beam-ttm/simulaciones/sonnet/adsb_patch/reports/limitations.md

# Limitaciones y estado de validación

- **Simulación sin completar:** el primer ensayo local falló por licencia y otros intentos locales fueron terminados por falta de memoria. El servidor remoto Windows ya es accesible. El intento del 19/10/2026 a las 16:24:24 comenzó a 0,8 GHz y falló en el mallado conformal. Se cambió el mallado planar a RECTANGULAR, conservando la geometría; falta repetirlo. No hay resultados S11 ni de radiación completados y no se realizó convergencia.
- **Geometría de alimentación existente:** el relleno F.Cu es una zona sin net asignada y deja un despeje de 0,2545 mm respecto del pad RF. La separación fue confirmada geométricamente y contra Gerber. No se reparó ni se asumió una unión ideal. La intención de diseño de esa separación no está determinada.
- **Material real sin certificar:** KiCad declara tanδ=0. Esto es una base sin pérdidas dieléctricas, no un valor físico validado. Los nombres JLC2116/JLC Core no bastan para seleccionar inequívocamente una ficha de laminado. El caso tanδ=0,016 es sensibilidad ilustrativa. σCu=5,8×10⁷ S/m es una hipótesis de cobre macizo liso usada también en ejemplos de Sonnet, no una medición de la lámina fabricada. No se incluyen rugosidad ni acabado ENIG.
- **Pared metalizada desconocida:** se supone 25 µm, interpretable como pared alrededor de un diámetro interior igual al taladro nominal. El archivo de fabricación no aclara aquí diámetro terminado frente a diámetro de herramienta. Se incluyen casos de 10 y 35 µm para la vía RF. La sección circular se aproxima por polígonos con error de cuerda máximo de 1 µm; la malla del solver introduce otra aproximación.
- **Dieléctrico finito:** Sonnet GEO utiliza capas uniformes extendidas hasta la caja. El contorno real se conserva en el JSON y en el recorte del cobre, pero no se representa el borde lateral FR4/aire de la placa con un sólido dieléctrico finito. Los interiores de perforaciones tampoco se sustituyen por cilindros de aire dentro de las capas uniformes. Esto puede afectar el campo y la radiación; contrastar con un solver 3D si es necesario.
- **Máscaras omitidas:** el Gerber Job declara 10 µm por cara y 1,598 mm total. Cobre más dieléctricos suma 1,578 mm; no se oculta la diferencia. Las propiedades RF de las máscaras no están disponibles.
- **Modelo de lámina:** se usa THIN_METAL con espesores físicos para pérdidas y planos situados en centros de lámina. La propagación entre centros utiliza el dieléctrico adyacente en la corrección de medio espesor de cobre. No es un volumen 3D exacto de las cuatro láminas.
- **Excitación local:** terminal flotante +1 en pad de D1 y −1 en cobre de masa adyacente; referencia de 50 Ω. Se conservan pads/pistas del resto de la electrónica, pero no componentes, soldadura, cables, conectores, receptor, cargas, selección física del jumper ni estructura del CubeSat. Las redes abiertas pueden acoplarse electromagnéticamente; no es el S11 de todo el equipo montado.
- **Discretización y caja pendientes:** se preparan celdas 100/50/25 µm, cajas 1600/2000/2400 mm y alturas de aire 30/40/50 mm. Las paredes laterales son PEC; las tapas Free Space aproximan absorción. Aumentar caja y refinar malla simultáneamente puede requerir mucha memoria. No se ha demostrado independencia de caja ni de malla.
- **Modelo B:** se entrega un control que elimina sólo el barril RF, manteniendo el mismo cobre y excitación. No se representa como una conexión ideal. Un modelo ideal completo requiere definir cómo se pretende excitar el patch separado; no se inventó un circuito equivalente.
- **Verificación parcial:** la comparación independiente de cobre, contorno y perforaciones acredita la conversión geométrica dentro de la tolerancia indicada. `verify_project` y `get num_ports` acreditan que Sonnet interpreta el archivo y reconoce un puerto. Ninguna de estas comprobaciones valida resonancia, adaptación, radiación o polarización.

Los archivos `reports/*_prepare.log`, `reports/*_prepare.json`, `reports/*_xml_verification.json`, `reports/geometry_verification.json` y `reports/solver_status.json` distinguen estas comprobaciones de una simulación completada.
