beam-ttm/simulaciones/diseno_final_patch_1090/imagenes_stand/04_render_3d_top_patch_gold.png

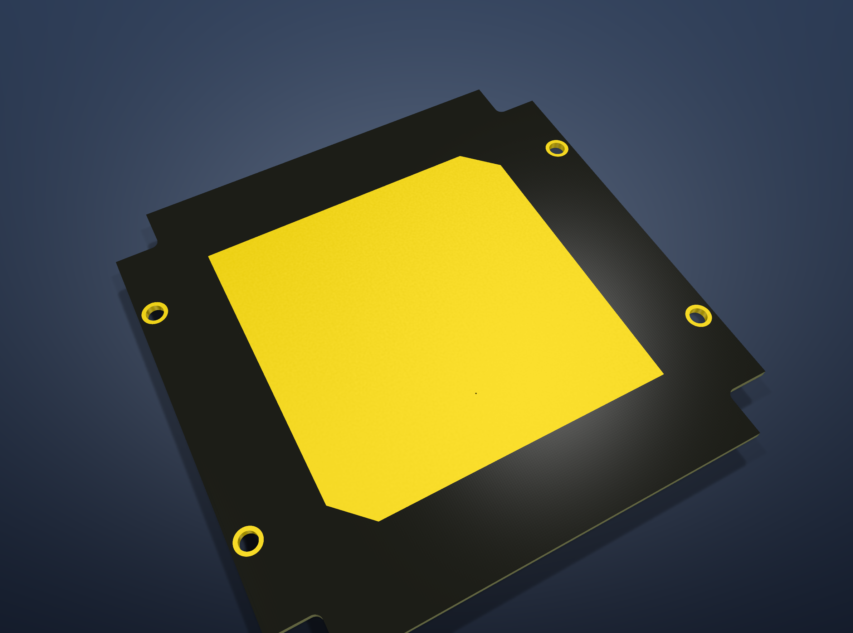
diseno_final_patch_1090/imagenes_stand/04_render_3d_top_patch_gold.png
