beam-ttm/simulaciones/diseno_final_patch_1090/imagenes_stand/05_render_3d_bottom_rf_unlam_beam.png

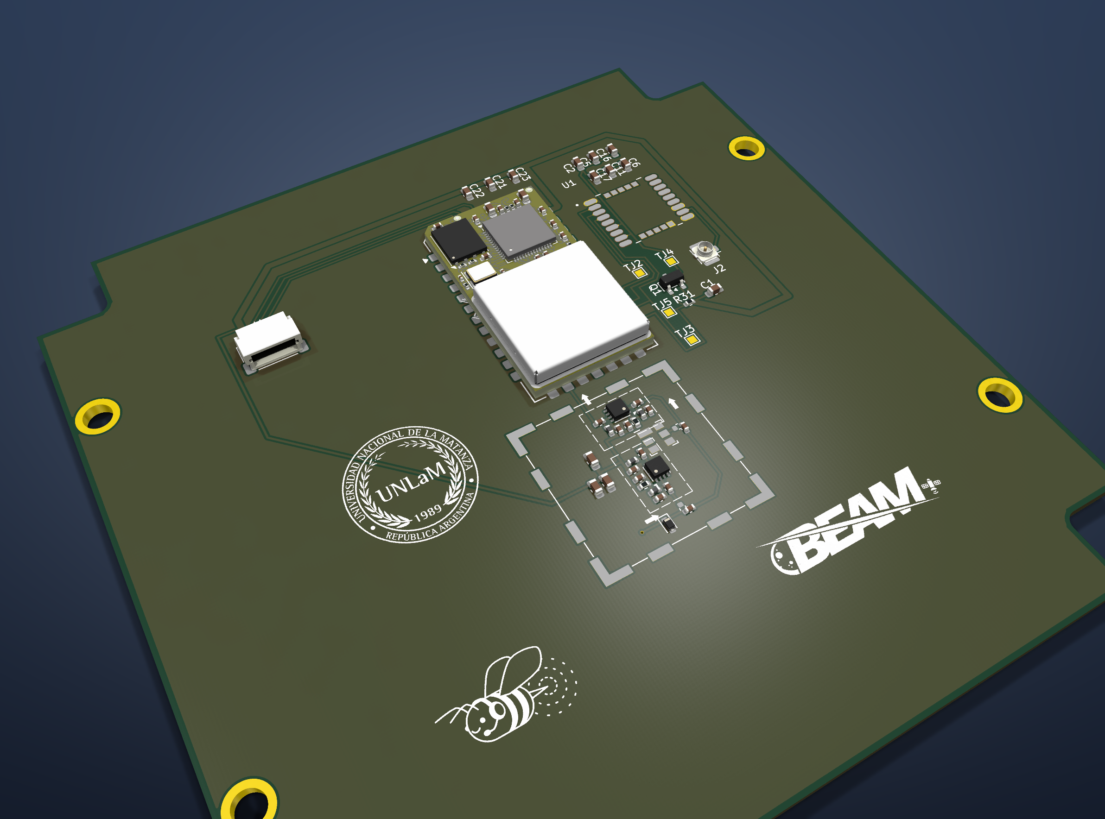
diseno_final_patch_1090/imagenes_stand/05_render_3d_bottom_rf_unlam_beam.png
