beam-ttm/simulaciones/diseno_final_patch_1090/imagenes_stand/detalle_level3_bcu_gcpw_sonnet.png

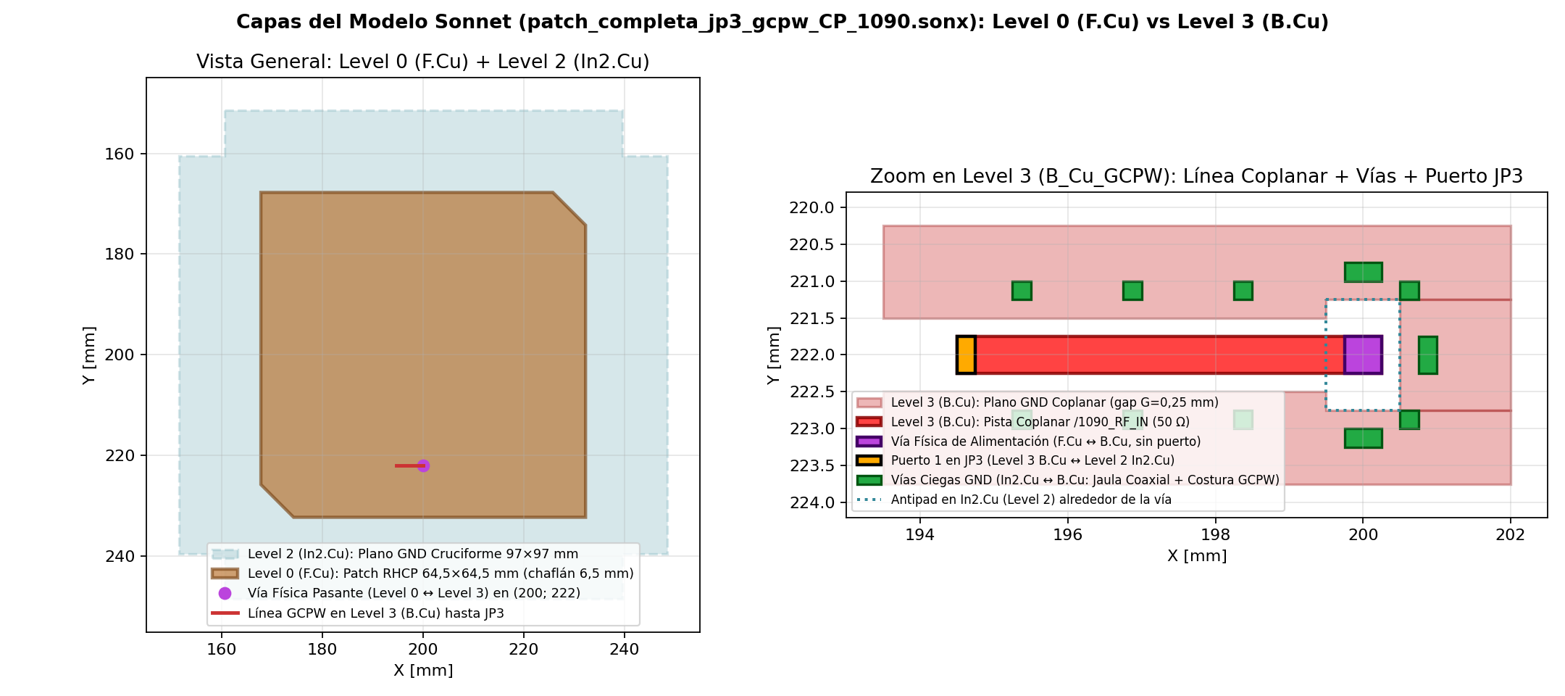
diseno_final_patch_1090/imagenes_stand/detalle_level3_bcu_gcpw_sonnet.png
