beam-ttm/simulaciones/sonnet/adsb_patch/reports/altium_sonnet_comparison.png

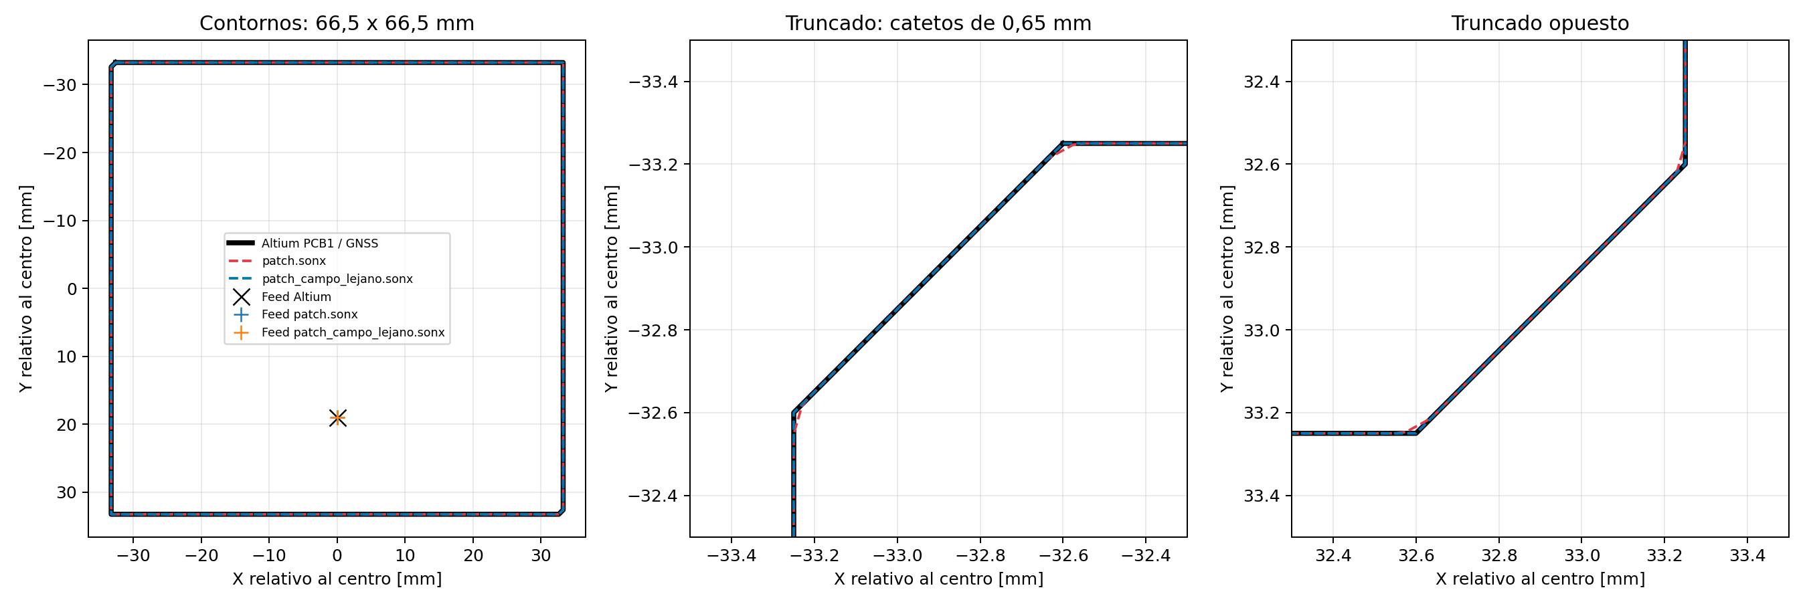
sonnet/adsb_patch/reports/altium_sonnet_comparison.png
