beam-ttm/simulaciones/sonnet/adsb_patch/reports/copper_layers.png

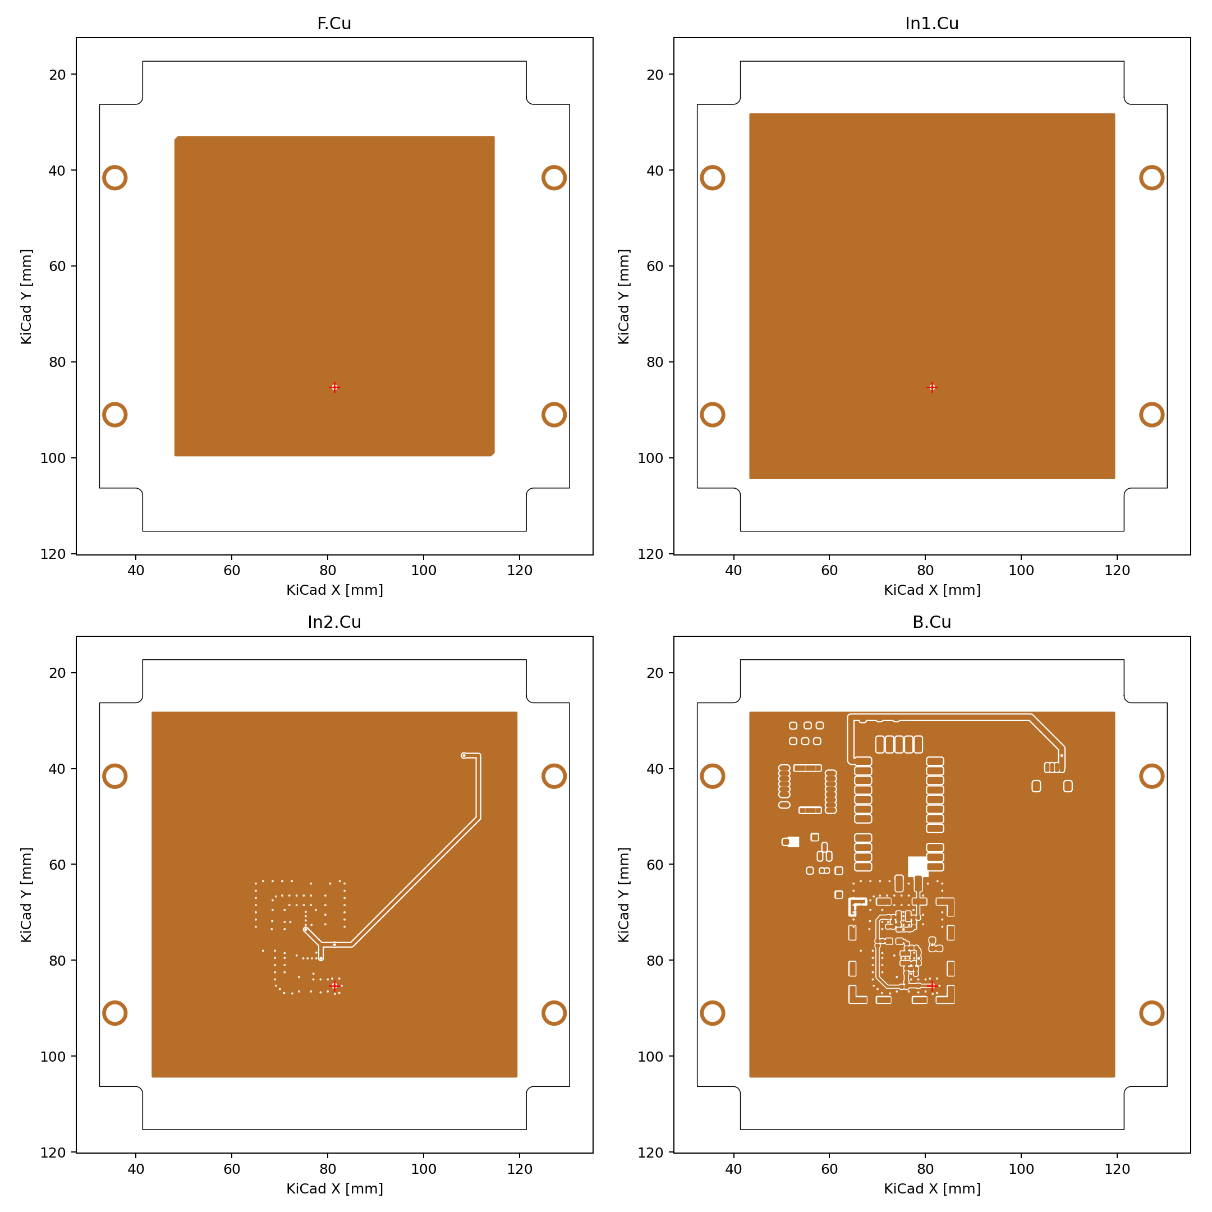
sonnet/adsb_patch/reports/copper_layers.png
