beam-ttm/simulaciones/sonnet/adsb_patch/reports/feed_via_detail.png

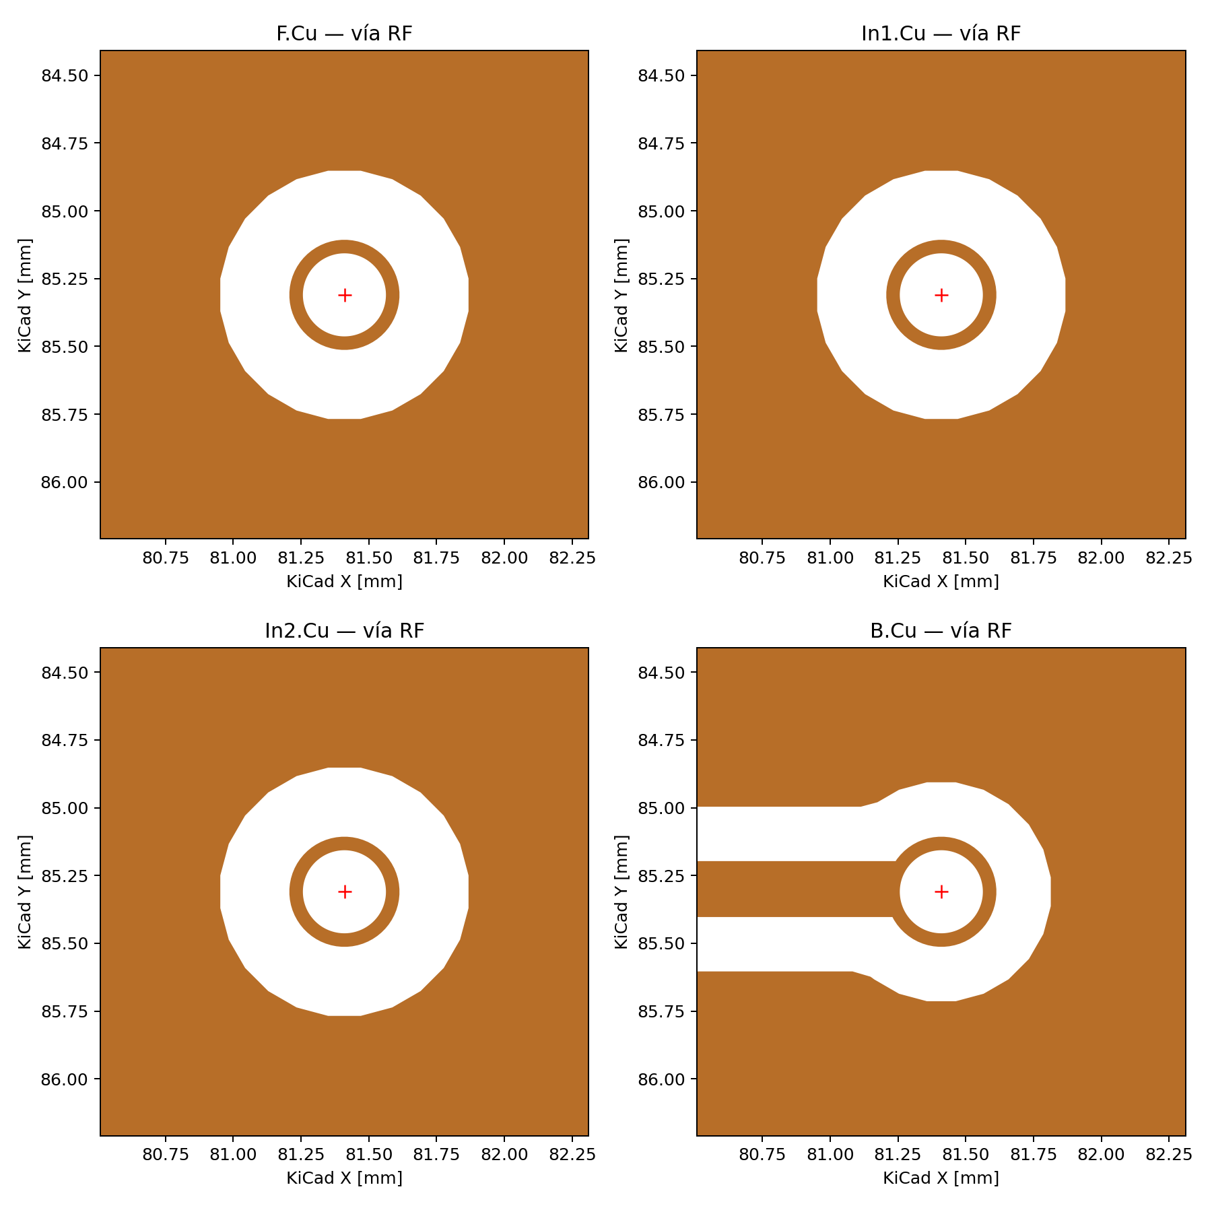
sonnet/adsb_patch/reports/feed_via_detail.png
