beam-ttm/simulaciones/sonnet/adsb_patch/results/patch_2caras_h16/patch_2caras_h16_barrido_rapido.csv

frequency_Hz | S11_real | S11_imag | S11_dB | return_loss_dB | VSWR | Zin_real_ohm | Zin_imag_ohm
800000000.0 | -0.952092726177147 | 0.285822625073251 | -0.05166079474580209 | 0.05166079474580209 | 336.26719394841723 | 0.15189841100020715 | 7.343169237821474
802000000.0 | -0.951500651691796 | 0.287531329952107 | -0.05230854953286738 | 0.05230854953286738 | 332.1031061597402 | 0.15384418805066188 | 7.389596057320951
804000000.0 | -0.950899383718565 | 0.289251860244356 | -0.052974438229811065 | 0.052974438229811065 | 327.92859545646576 | 0.1558449388642854 | 7.43640167800003
806000000.0 | -0.950288692364075 | 0.290984483398063 | -0.053659023360235196 | 0.053659023360235196 | 323.74488830898673 | 0.1579024001570856 | 7.4835953135473465
808000000.0 | -0.949668339486988 | 0.292729474259709 | -0.05436289053086747 | 0.05436289053086747 | 319.5532064948163 | 0.1600183810180816 | 7.531186464974012
810000000.0 | -0.94903807833877 | 0.294487115325254 | -0.05508664954260451 | 0.05508664954260451 | 315.35476649425874 | 0.1621947664573099 | 7.579184931957993
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
