beam-ttm/simulaciones/sonnet/adsb_patch/results/patch_2caras_h16/patch_2caras_h16_rect_b1228.8_c100um_local.csv

frequency_Hz | S11_real | S11_imag | S11_dB | return_loss_dB | VSWR | Zin_real_ohm | Zin_imag_ohm
1090000000.0 | -0.568895073187 | -0.360107620829 | -3.435959793780178 | 3.435959793780178 | 5.1216324559836846 | 10.549167258824852 | -13.897816965197206
