beam-ttm/simulaciones/sonnet/adsb_patch/results/patch_2caras_h16/patch_2caras_h16_rect_b1638.4_c100um.csv

frequency_Hz | S11_real | S11_imag | S11_dB | return_loss_dB | VSWR | Zin_real_ohm | Zin_imag_ohm
1090000000.0 | -0.568895144267 | -0.360107622907 | -3.4359590046417403 | 3.4359590046417403 | 5.121633602144371 | 10.549164755206556 | -13.897815841089136
