beam-ttm/simulaciones/sonnet/adsb_patch/results/patch_2caras_h16/patch_2caras_h16_rect_b1638.4_c100um_campo.csv

/home/alan/Escritorio/CubeSat/sonnet/patch_2caras_h16_rect_b1638.4_c100um.sonx
Theta (Degrees) | patch_2caras_h16_rect_b1638.4_c100um: E-Total F=1.09 GHz Phi=0°
-90 | -112.121905735198
-85 | -11.3234848083483
-80 | -9.35300397293157
-75 | -8.35842430719048
-70 | -7.55311200414934
-65 | -6.82494420938843
-60 | -6.15015987942218
-55 | -5.52362705266198
-50 | -4.94507494036574
-45 | -4.41560759719049
-40 | -3.93670071696576
-35 | -3.50988862893889
-30 | -3.13665357085377
-25 | -2.81837323176936
-20 | -2.55628408725714
-15 | -2.35144955375734
-10 | -2.20473156005572
-5 | -2.11676661895773
0 | -2.08794774494923
5 | -2.1184132215203
10 | -2.20804278328059
15 | -2.35646136493169
20 | -2.5630501725643
25 | -2.82696441202545
30 | -3.14715655323808
35 | -3.52240363571208
40 | -3.95133732951932
45 | -4.43247786259532
50 | -4.96428235559109
55 | -5.54524939668507
60 | -6.17422292138856
65 | -6.85138200670733
70 | -7.58170769370074
75 | -8.38872164626692
80 | -9.38415822947032
85 | -11.3536927294109
90 | -112.153570489642
/home/alan/Escritorio/CubeSat/sonnet/patch_2caras_h16_rect_b1638.4_c100um.sonx
Theta (Degrees) | patch_2caras_h16_rect_b1638.4_c100um: E-Total F=1.09 GHz Phi=90°
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
