beam-ttm/simulaciones/sonnet/adsb_patch/results/patch_2caras_h16/patch_2caras_h16_rect_b1638.4_c100um_esfera.csv

/home/alan/Escritorio/CubeSat/sonnet/patch_2caras_h16_rect_b1638.4_c100um.sonx
Theta (Degrees) | patch_2caras_h16_rect_b1638.4_c100um: E-Total F=1.09 GHz Phi=0°
0 | -2.08794774494923
5 | -2.1184132215203
10 | -2.20804278328059
15 | -2.35646136493169
20 | -2.5630501725643
25 | -2.82696441202545
30 | -3.14715655323808
35 | -3.52240363571208
40 | -3.95133732951932
45 | -4.43247786259532
50 | -4.96428235559109
55 | -5.54524939668507
60 | -6.17422292138856
65 | -6.85138200670733
70 | -7.58170769370074
75 | -8.38872164626692
80 | -9.38415822947032
85 | -11.3536927294109
90 | -112.153570489642
95 | -13.9418052796713
100 | -13.2319880651126
105 | -13.3039887532304
110 | -13.2998663606515
115 | -13.0872919614549
120 | -12.6758919208192
125 | -12.1249591229616
130 | -11.5017815809644
135 | -10.8617560000337
140 | -10.2437454833577
145 | -9.67263376846781
150 | -9.1635205341337
155 | -8.72527886400405
160 | -8.36302010298955
165 | -8.07964796989636
170 | -7.87678847565395
175 | -7.75532595321573
180 | -7.71569811191792
/home/alan/Escritorio/CubeSat/sonnet/patch_2caras_h16_rect_b1638.4_c100um.sonx
Theta (Degrees) | patch_2caras_h16_rect_b1638.4_c100um: E-Total F=1.09 GHz Phi=5°
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
