beam-ttm/simulaciones/sonnet/adsb_patch/results/patch_2caras_h16/patch_2caras_h16_rect_b400_c100um.csv

frequency_Hz | S11_real | S11_imag | S11_dB | return_loss_dB | VSWR | Zin_real_ohm | Zin_imag_ohm
1090000000.0 | -0.568700864052 | -0.359712930546 | -3.440800916845615 | 3.440800916845615 | 5.114611133798603 | 10.562554985654742 | -13.887373070587529
