beam-ttm/simulaciones/diseno_final_patch_1090/imagenes_stand/pcb_1090_edge_cuts_verificacion.png

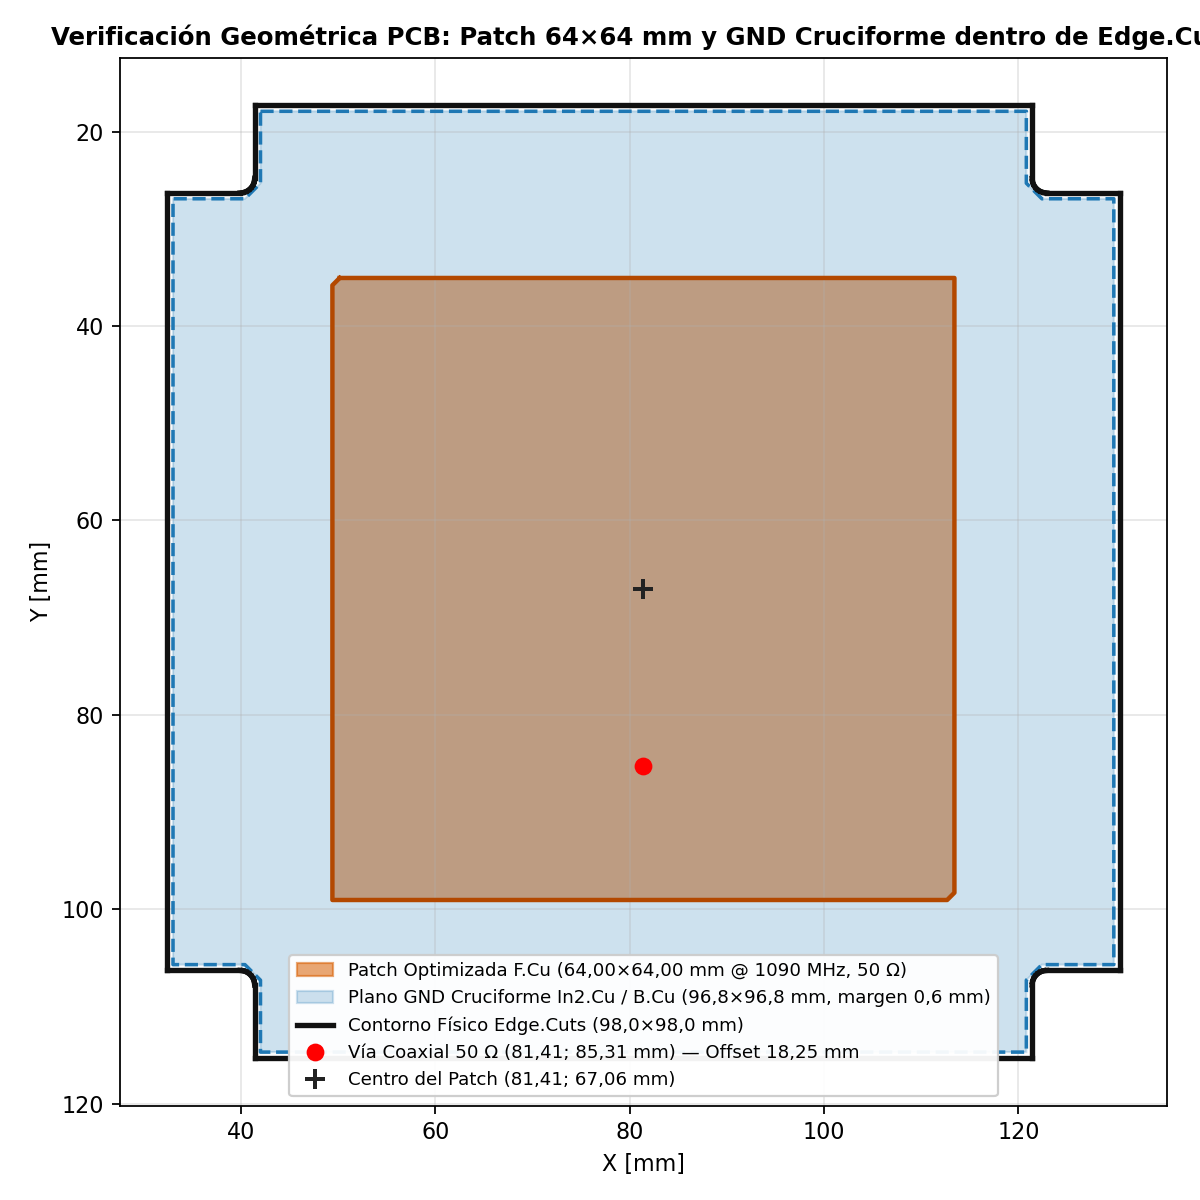
diseno_final_patch_1090/imagenes_stand/pcb_1090_edge_cuts_verificacion.png
