beam-ttm/simulaciones/diseno_final_patch_1090/imagenes_stand/resultados_reales_jp3_rhcp_1090.png

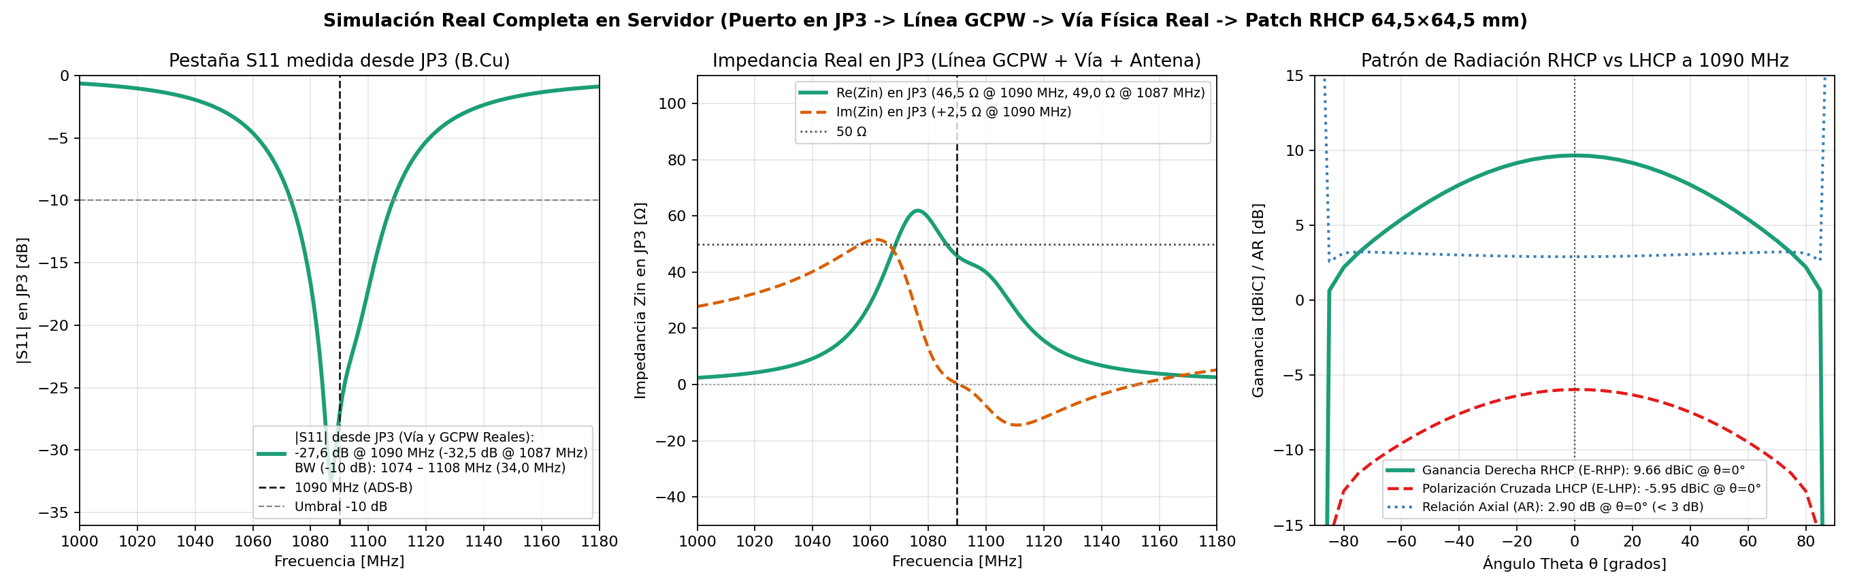
diseno_final_patch_1090/imagenes_stand/resultados_reales_jp3_rhcp_1090.png
