beam-ttm/simulaciones/sonnet/adsb_patch/results/patch_2caras_h16/barrido_s11_zin_2caras_h16.png

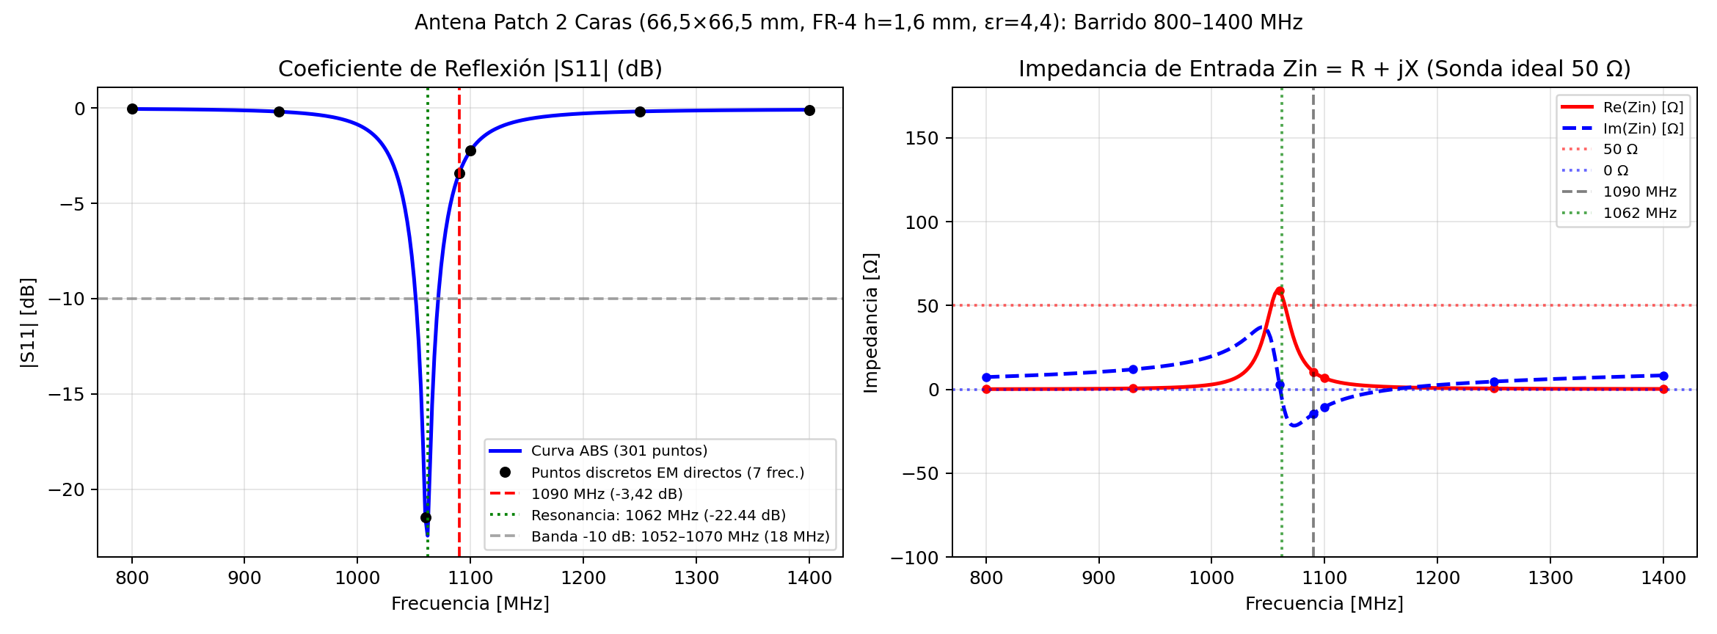
sonnet/adsb_patch/results/patch_2caras_h16/barrido_s11_zin_2caras_h16.png
