beam-ttm/simulaciones/sonnet/adsb_patch/results/patch_2caras_h16/bcu_ruteado_final.png

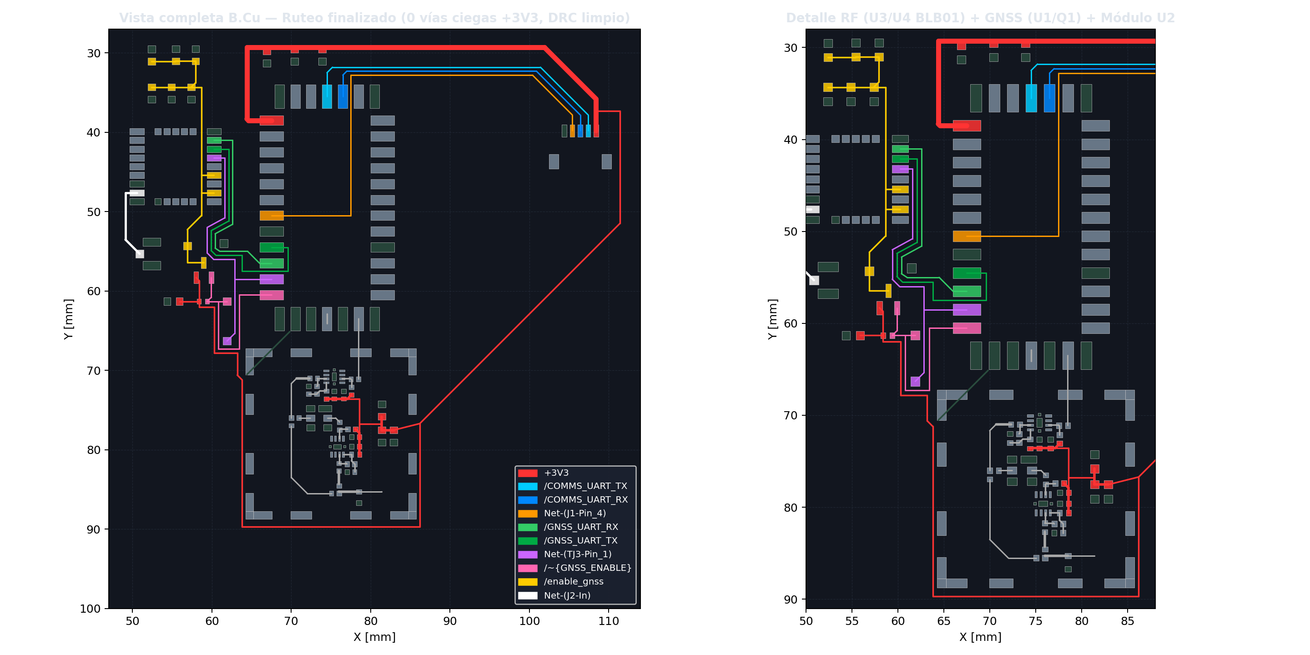
sonnet/adsb_patch/results/patch_2caras_h16/bcu_ruteado_final.png
