beam-ttm/simulaciones/sonnet/adsb_patch/results/patch_2caras_h16/comparacion_cajas_1090MHz.png

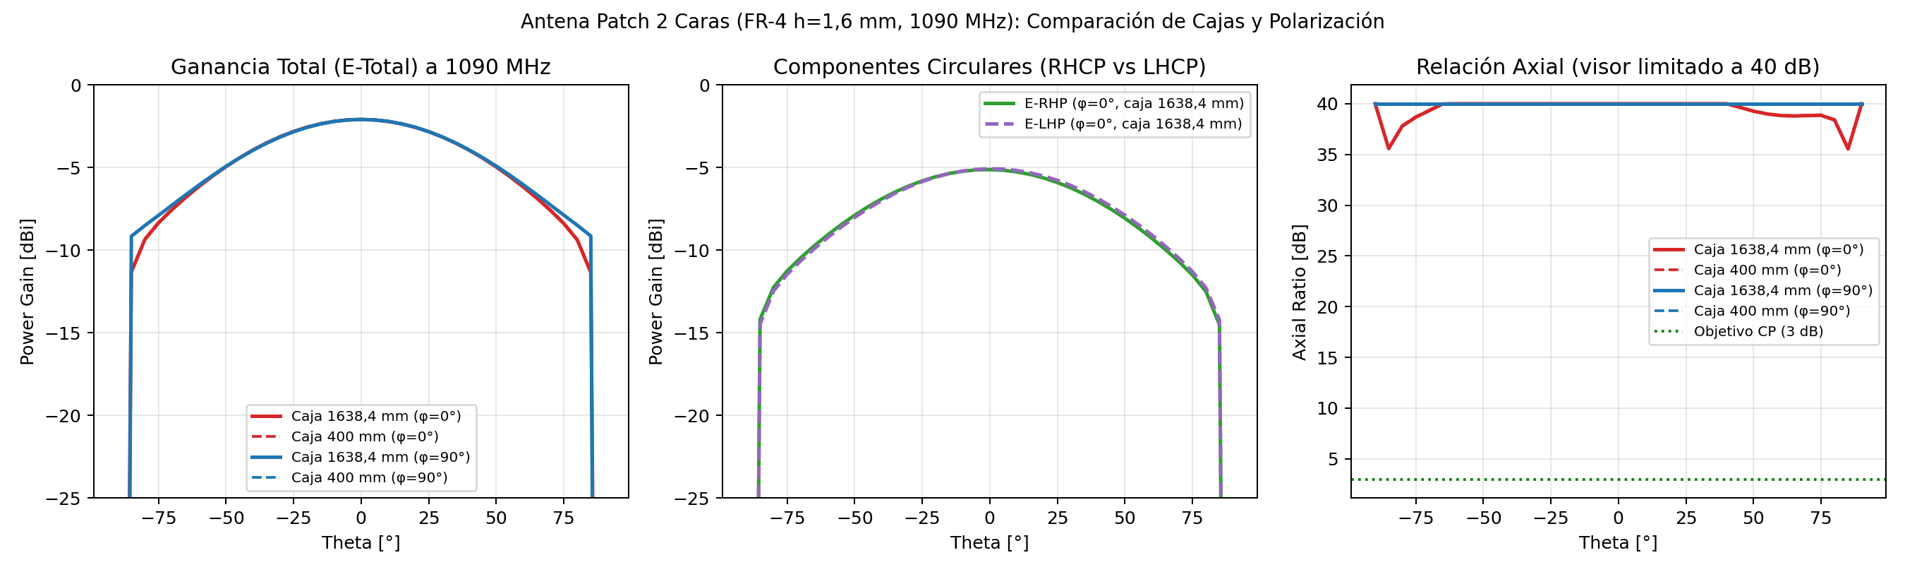
sonnet/adsb_patch/results/patch_2caras_h16/comparacion_cajas_1090MHz.png
