beam-ttm/simulaciones/sonnet/adsb_patch/results/patch_2caras_h16/jlc04161h_2116_stack_s11_zin.png

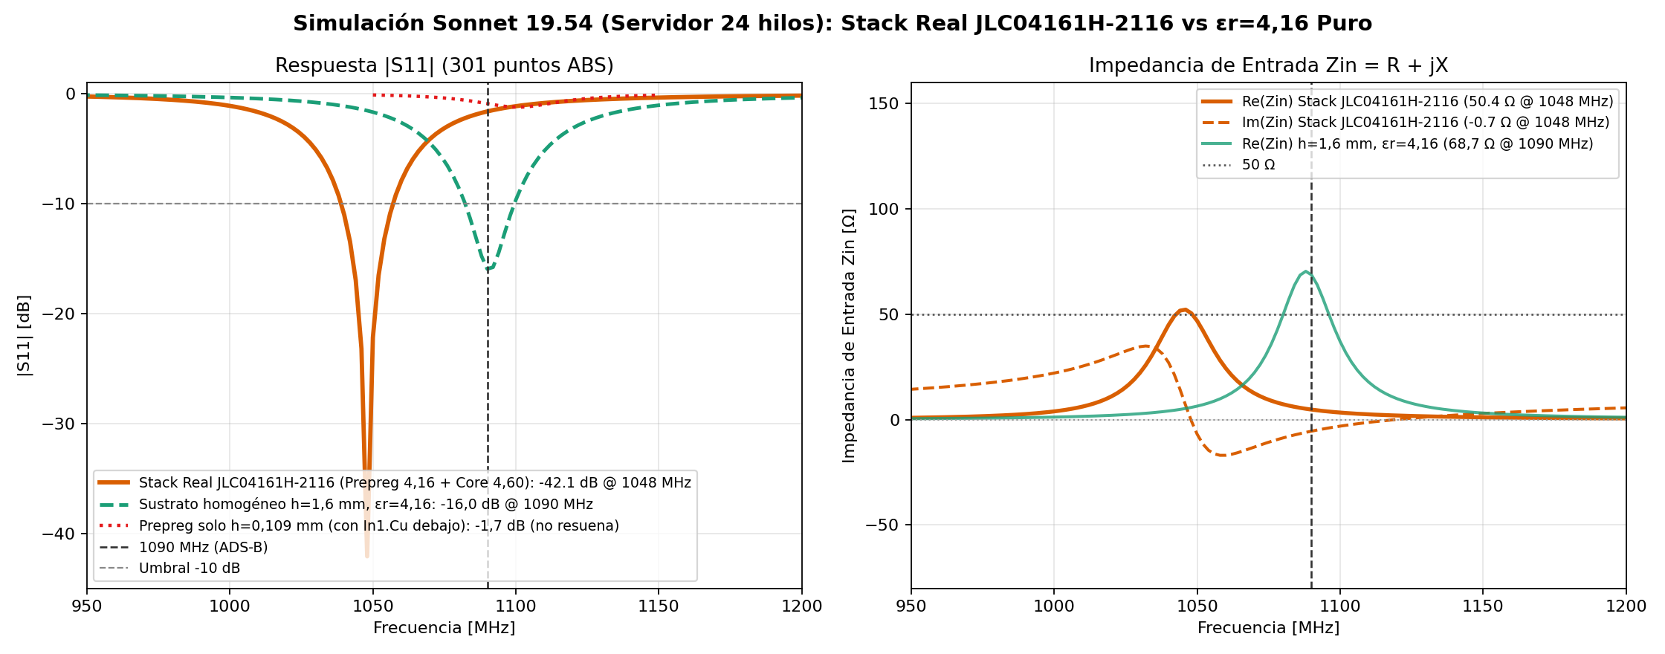
sonnet/adsb_patch/results/patch_2caras_h16/jlc04161h_2116_stack_s11_zin.png
