beam-ttm/simulaciones/sonnet/adsb_patch/results/patch_2caras_h16/mapa_completo_bcu.png

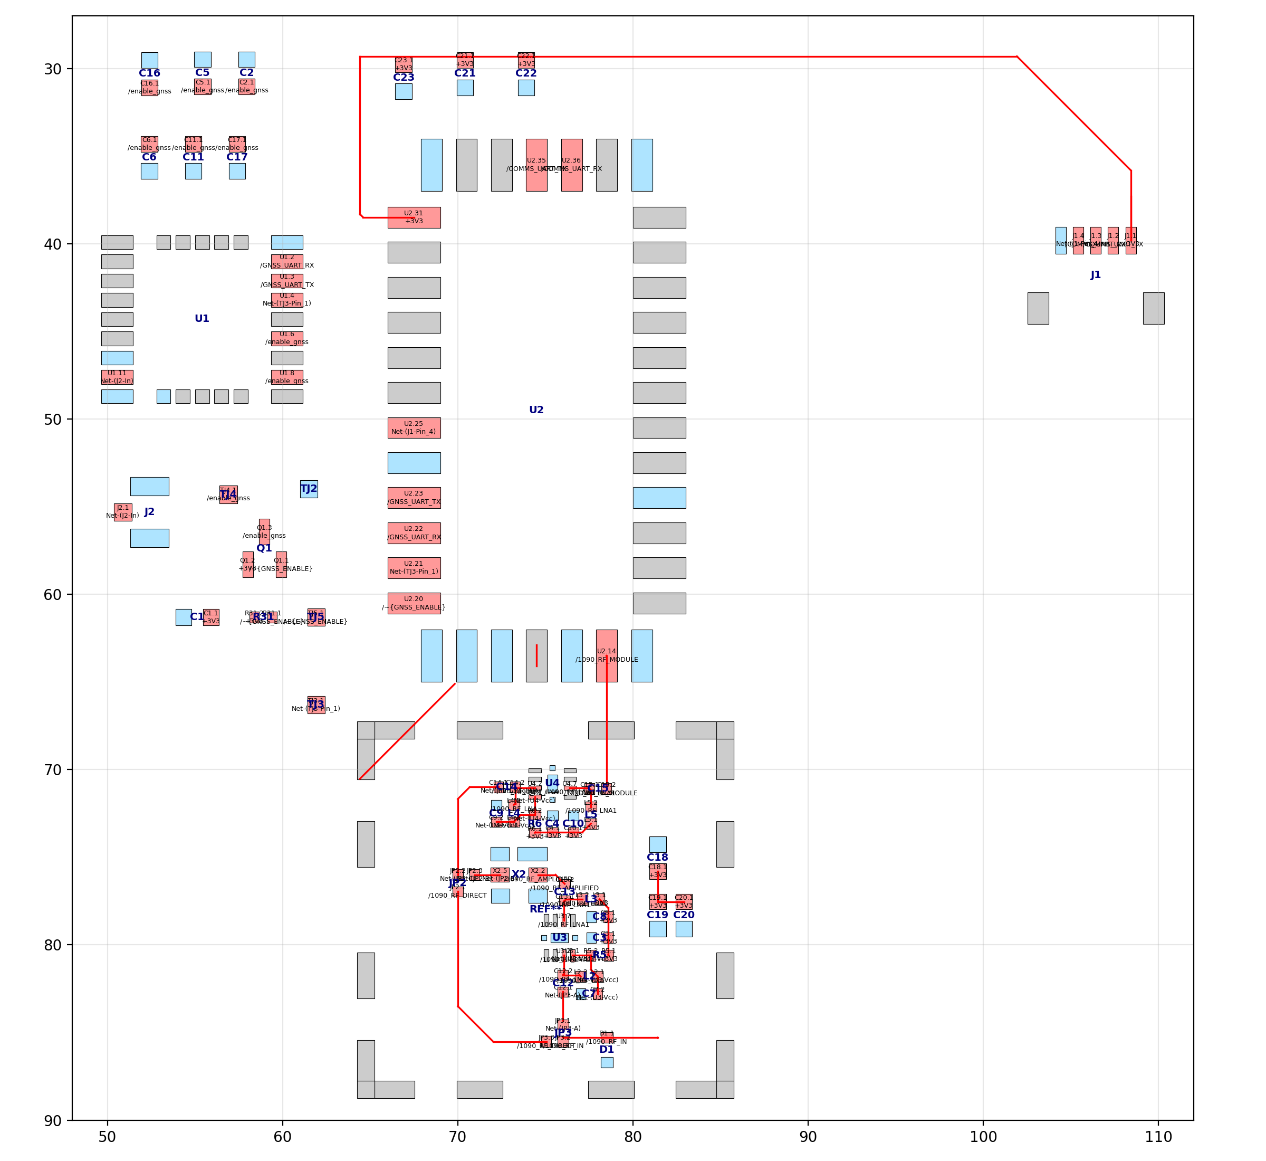
sonnet/adsb_patch/results/patch_2caras_h16/mapa_completo_bcu.png
