beam-ttm/simulaciones/sonnet/adsb_patch/results/patch_2caras_h16/patch_2caras_h16_barrido_rapido_s11.png

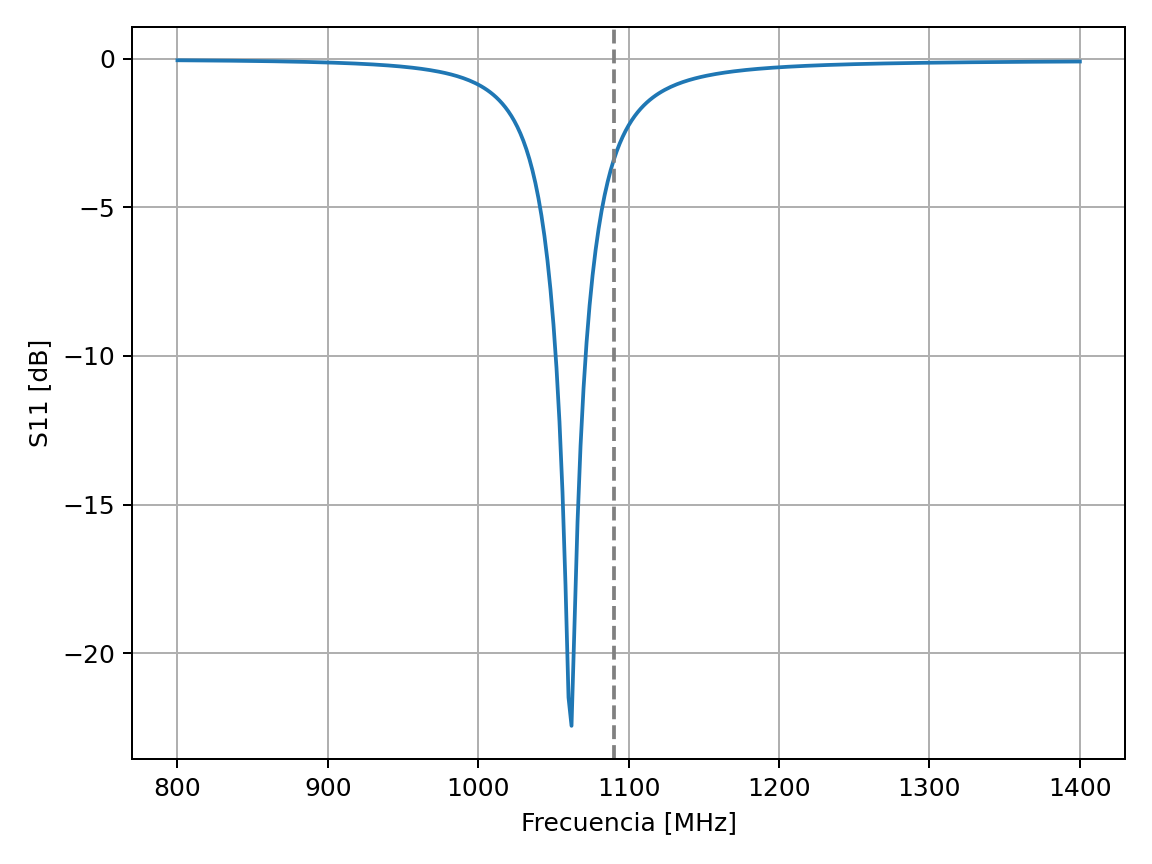
sonnet/adsb_patch/results/patch_2caras_h16/patch_2caras_h16_barrido_rapido_s11.png
