beam-ttm/simulaciones/sonnet/adsb_patch/results/patch_2caras_h16/patch_2caras_h16_rect_b400_c100um_s11.png

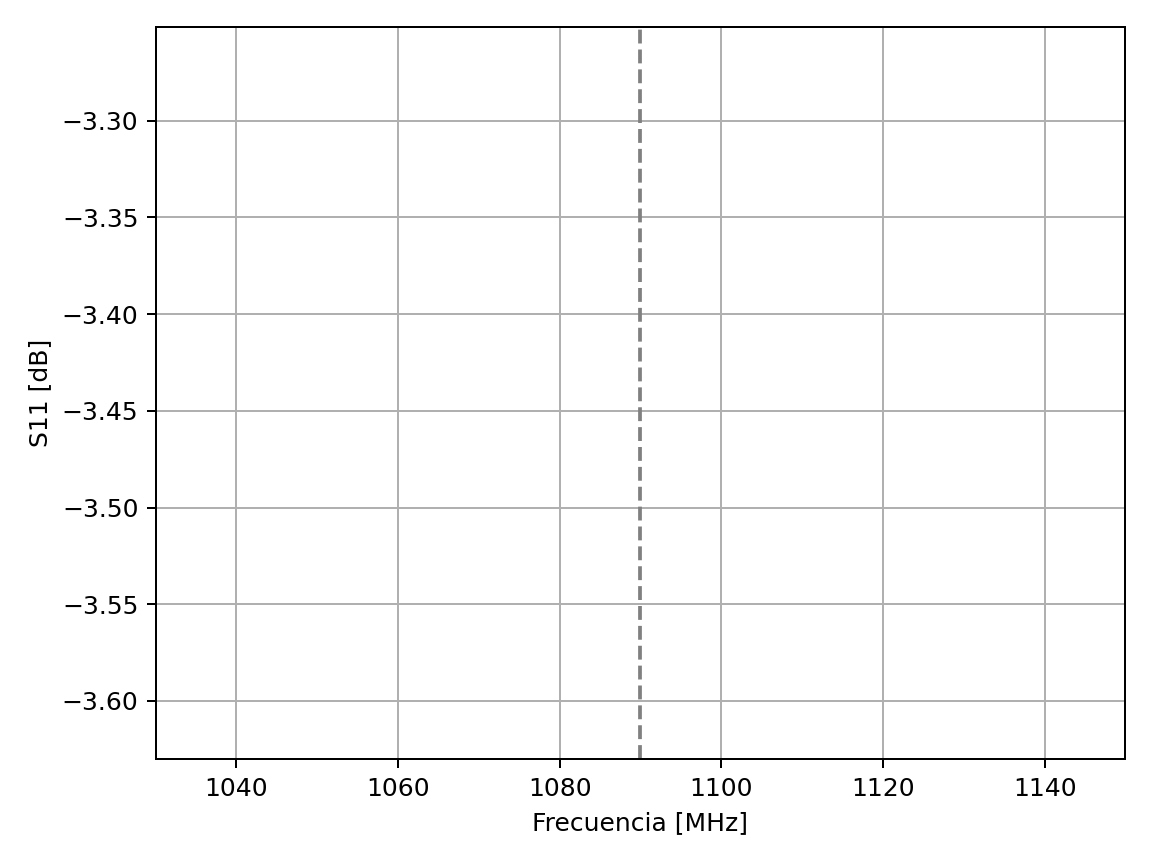
sonnet/adsb_patch/results/patch_2caras_h16/patch_2caras_h16_rect_b400_c100um_s11.png
