beam-ttm/simulaciones/sonnet/adsb_patch/results/patch_2caras_h16/patch_1090_optimizada_comparacion.png

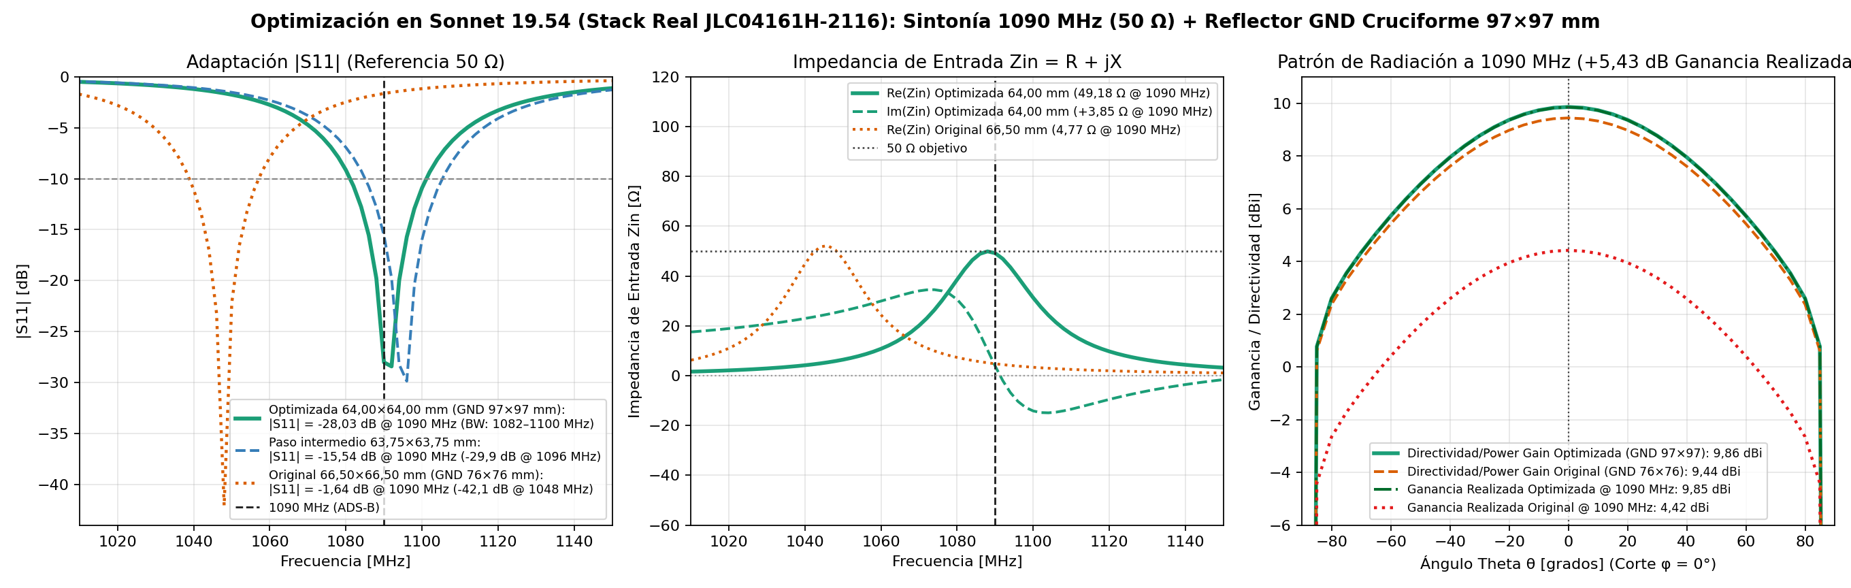
sonnet/adsb_patch/results/patch_2caras_h16/patch_1090_optimizada_comparacion.png
