beam-ttm/simulaciones/sonnet/adsb_patch/results/patch_2caras_h16/patch_jlc2116_h0109_er416_s11_zin.png

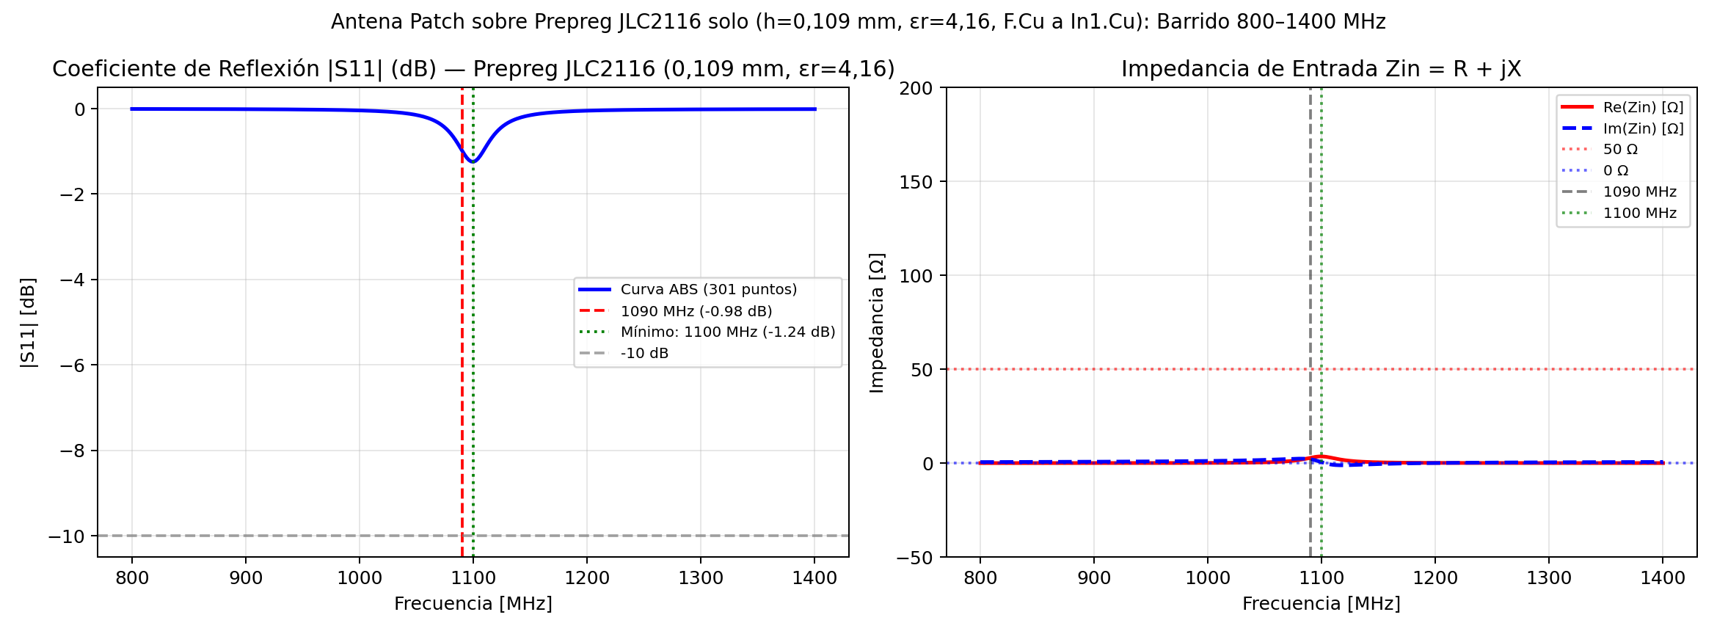
sonnet/adsb_patch/results/patch_2caras_h16/patch_jlc2116_h0109_er416_s11_zin.png
