beam-ttm/simulaciones/sonnet/adsb_patch/results/patch_2caras_h16/rf_coplanar_50ohm_vias.png

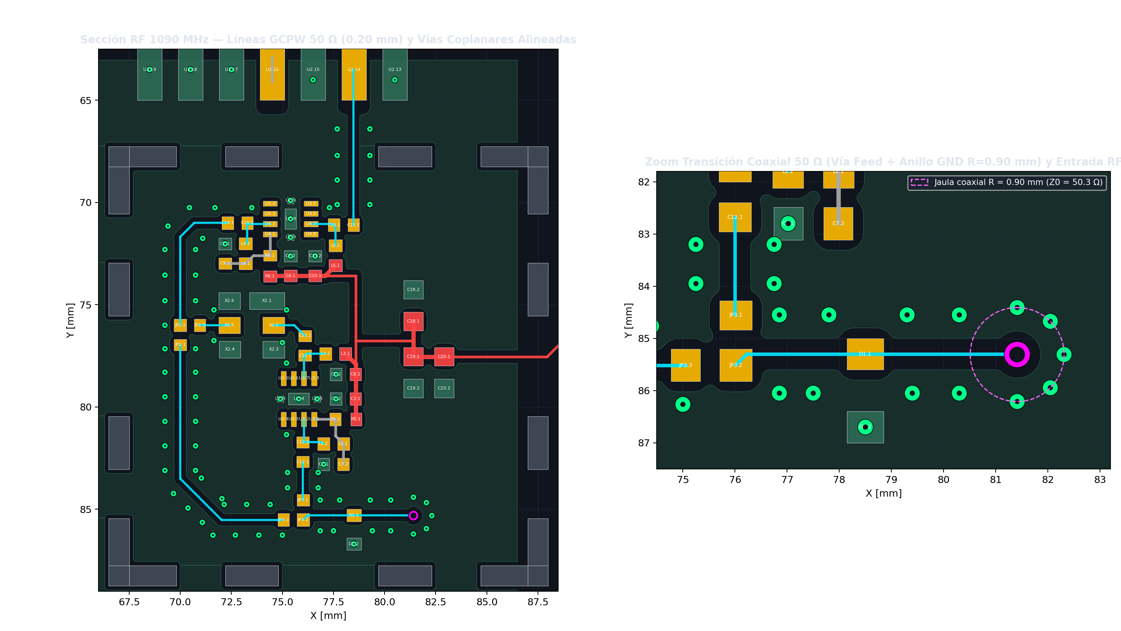
sonnet/adsb_patch/results/patch_2caras_h16/rf_coplanar_50ohm_vias.png
