beam-ttm/simulaciones/sonnet/adsb_patch/results/patch_2caras_h16/ruteo_3v3_blb01_bcu.png

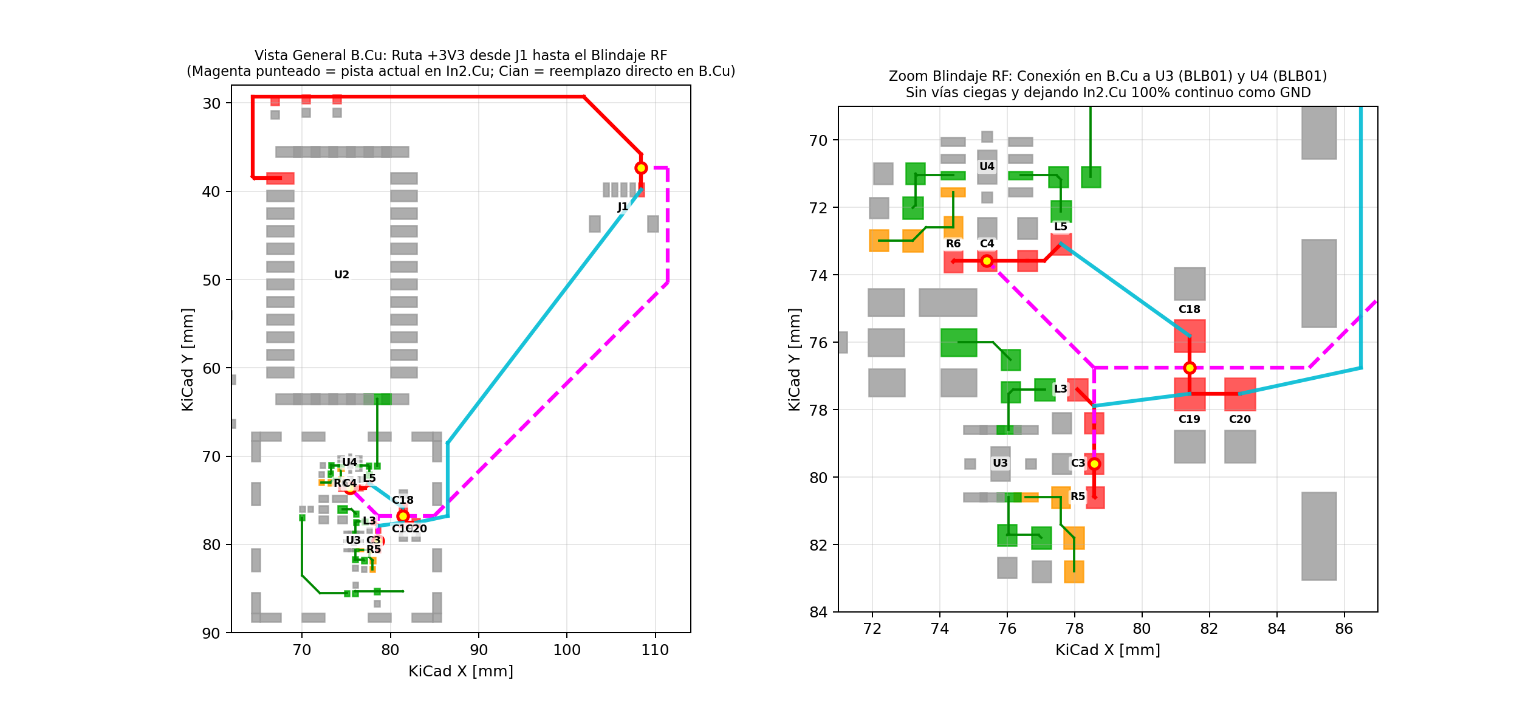
sonnet/adsb_patch/results/patch_2caras_h16/ruteo_3v3_blb01_bcu.png
