beam-ttm/simulaciones/sonnet/adsb_patch/results/simple_barrido/patch_simple_barrido_resultados_s11.png

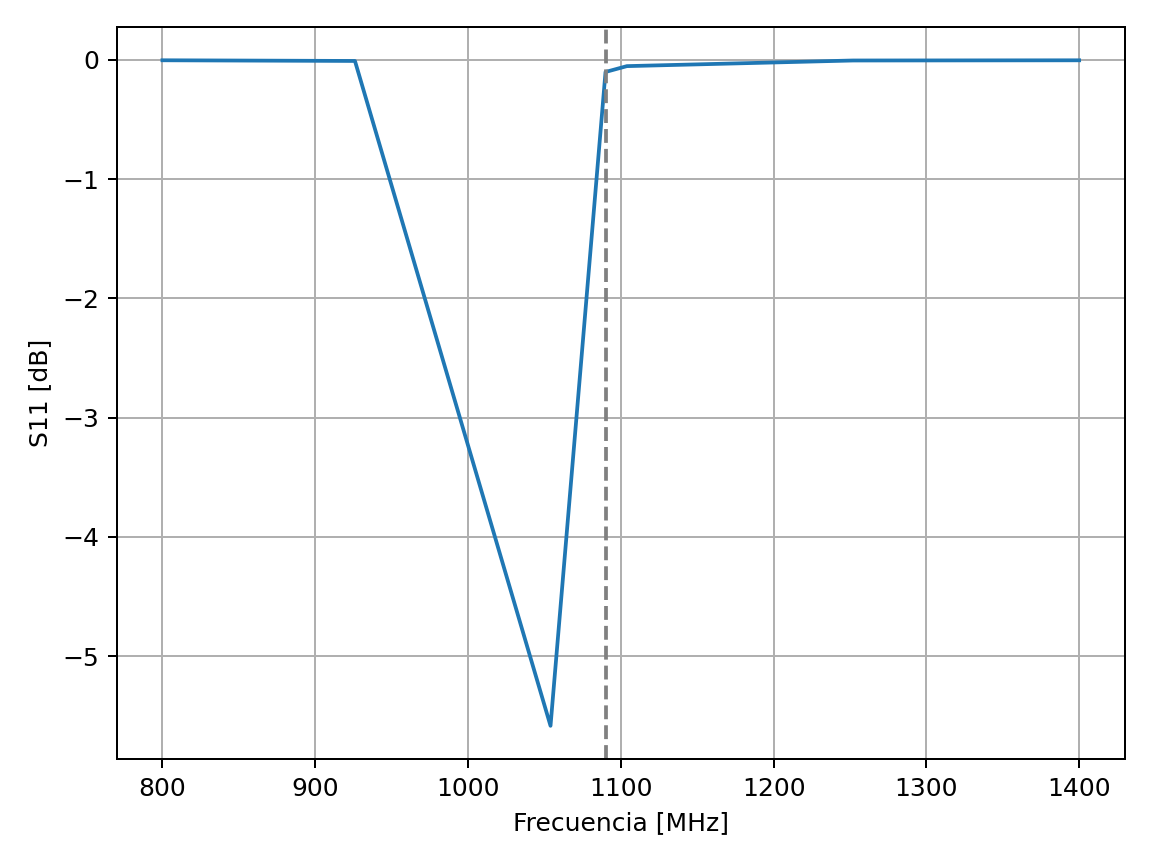
sonnet/adsb_patch/results/simple_barrido/patch_simple_barrido_resultados_s11.png
