beam-ttm/simulaciones/diseno_final_patch_1090/kicad/ads-b.kicad_pcb

## KiCad design diseno_final_patch_1090/kicad/ads-b.kicad_pcb (2026-10-28)

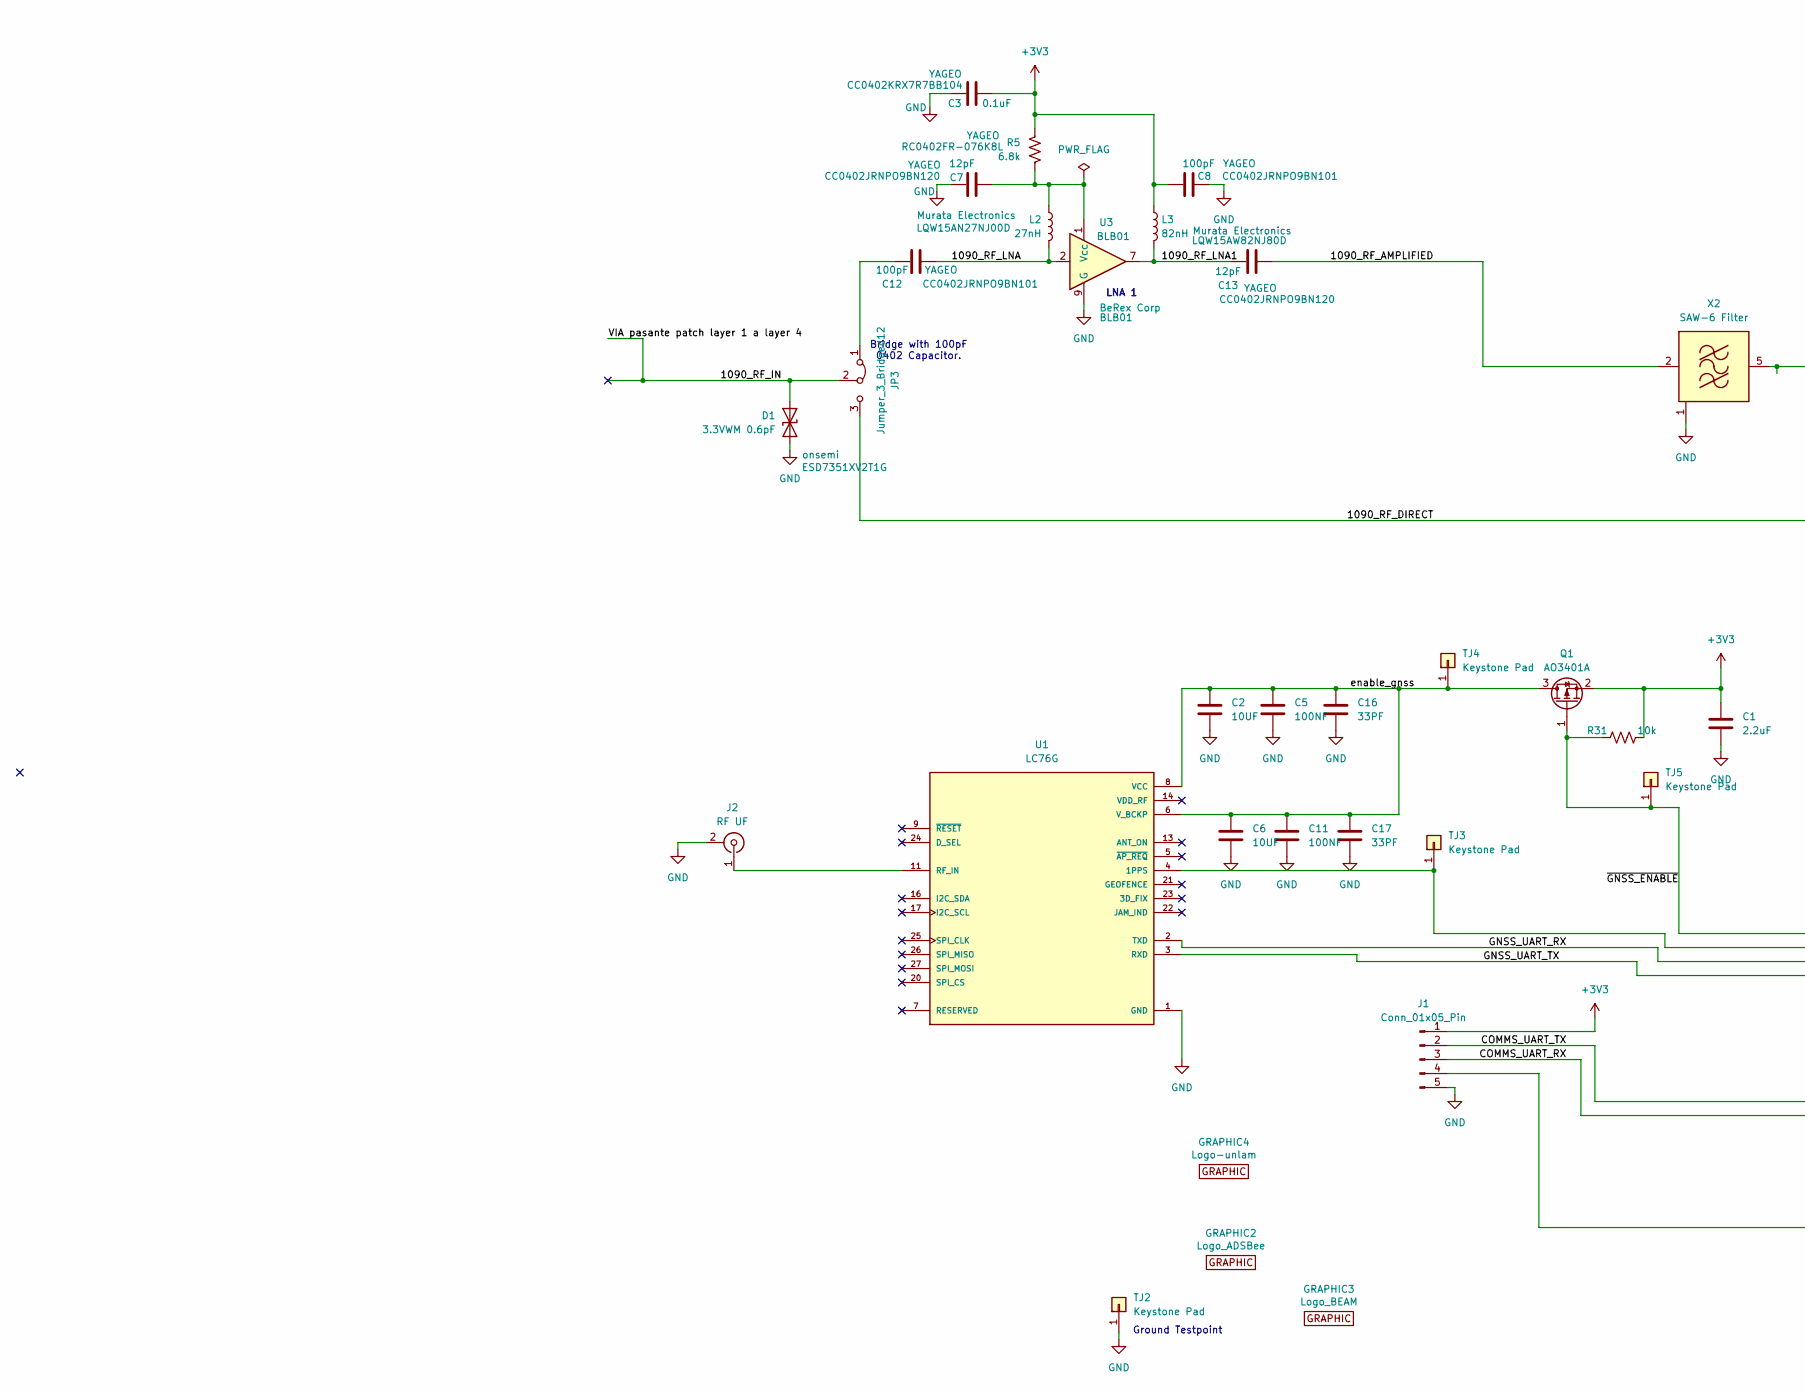
[picture p132: schematic ads-b.kicad_sch, RF FRONTEND ADS-B (B.E.A.M TTM) with ADSBee m1090, part in row 1, column 1]

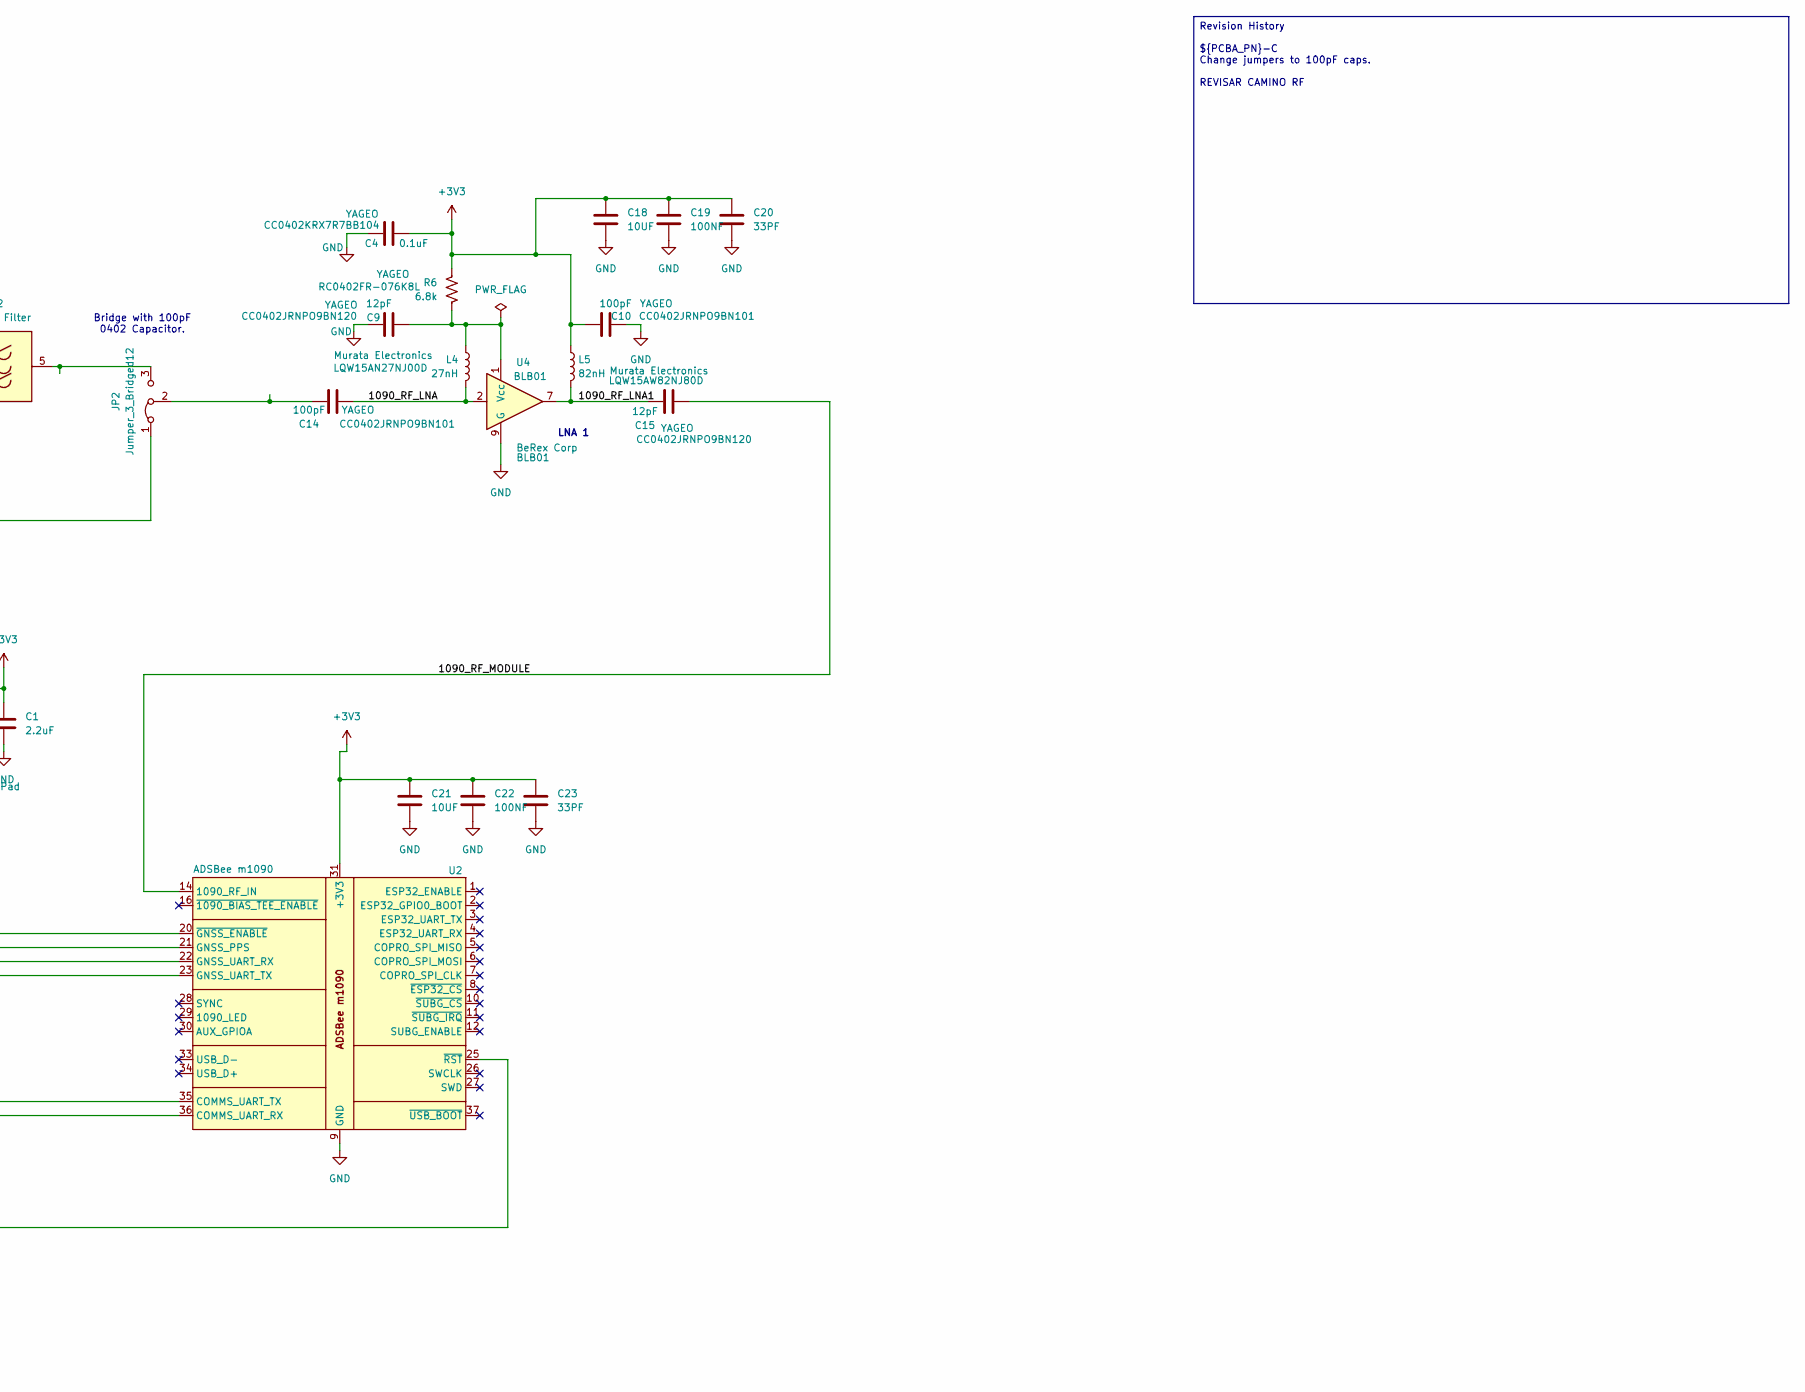
[picture p133: schematic ads-b.kicad_sch, RF FRONTEND ADS-B (B.E.A.M TTM) with ADSBee m1090, part in row 1, column 2]

Parts:
C1: 2.2uF; C_0603_1608Metric; Voltage 10V; MPN CL10B225KP8NNNC
C2, C6, C18, C21: 10UF; C_0603_1608Metric
C3, C4: 0.1uF; C_0402_1005Metric; Voltage 16V; Tolerance 10%; MPN CC0402KRX7R7BB104; LCSC PN C60474
C5, C11, C19, C22: 100NF; C_0603_1608Metric
C7, C9, C13, C15: 12pF; C_0402_1005Metric; Voltage 50V; Tolerance 5%; MPN CC0402JRNPO9BN120; LCSC PN C326662
C8, C10, C12, C14: 100pF; C_0402_1005Metric; Voltage 50V; Tolerance 5%; MPN CC0402JRNPO9BN101; LCSC PN C106200
C16, C17, C20, C23: 33PF; C_0603_1608Metric
D1: 3.3VWM 0.6pF; D_SOD-523; MPN ESD7351XV2T1G; LCSC PN C2912559
GRAPHIC2: Logo_ADSBee; ADSBeelogo
GRAPHIC3: Logo_BEAM; BEAM_logo_22.4mm
GRAPHIC4: Logo-unlam; ADSBeelogo
J1: Conn_01x05_Pin; JST_SH_SM05B-SRSS-TB_1x05-1MP_P1.00mm_Horizontal
J2: RF UF; U.FL_Hirose_U.FL-R-SMT-1_Vertical
JP2, JP3: Jumper_3_Bridged12; Jumper_C_0402_3Pole_Bridged12_3Down; MPN CC0402JRNPO9BN101; LCSC PN C106200
L2, L4: 27nH; L_0402_1005Metric; Tolerance 5%; MPN LQW15AN27NJ00D; LCSC PN C113112
L3, L5: 82nH; L_0402_1005Metric; Tolerance 5%; MPN LQW15AW82NJ80D; LCSC PN C3222285
Q1: AO3401A; SOT-23
R5, R6: 6.8k; R_0402_1005Metric; Tolerance 1%; MPN RC0402FR-076K8L; LCSC PN C93940
R31: 10k; R_0402_1005Metric; Tolerance 1%; MPN RC0402FR-0710KL; LCSC PN C60490
TJ2, TJ3, TJ4, TJ5: Keystone Pad; TestPoint_Pad_1.0x1.0mm; MPN 5015; LCSC PN C2906768
U1: LC76G; XCVR_LC76G; PARTREV 1.0
U2: ADSBee m1090; PantsForBirds_ADSBee_m1090_Module
U3, U4: BLB01; Berex_DFN-8-1EP_2x2mm_P0.5mm_SmallPadWithDots; MPN BLB01
X2: SAW-6 Filter; Filter_SAW-6_3.0x3.0mm

Connections:
+3V3: C1.1, C3.1, C4.1, C8.1, C10.1, C18.1, C19.1, C20.1, C21.1, C22.1, C23.1, J1.1, L3.1, L5.1, Q1.2 (S), R5.1, R6.1, R31.2, U2.31 (+3V3)
/1090_RF_AMPLIFIED: C13.2, X2.2 (IN)
/1090_RF_DIRECT: JP2.1 (A), JP3.3 (B)
/1090_RF_IN: D1.1 (A1), JP3.2 (C)
/1090_RF_LNA: C12.2, C14.2, L2.2, L4.2, U3.2, U4.2
/1090_RF_LNA1: C13.1, C15.1, L3.2, L5.2, U3.7, U4.7
/1090_RF_MODULE: C15.2, U2.14 (1090_RF_IN)
/COMMS_UART_RX: J1.3, U2.36 (COMMS_UART_RX)
/COMMS_UART_TX: J1.2, U2.35 (COMMS_UART_TX)
/GNSS_UART_RX: U1.2 (TXD), U2.22 (GNSS_UART_RX)
/GNSS_UART_TX: U1.3 (RXD), U2.23 (GNSS_UART_TX)
/enable_gnss: C2.1, C5.1, C6.1, C11.1, C16.1, C17.1, Q1.3 (D), TJ4.1 (Pin_1_1), U1.6 (V_BCKP), U1.8 (VCC)
/~GNSS_ENABLE: Q1.1 (G), R31.1, TJ5.1 (Pin_1_1), U2.20 (~GNSS_ENABLE)
GND: C1.2, C2.2, C3.2, C4.2, C5.2, C6.2, C7.1, C8.2, C9.1, C10.2, C11.2, C16.2, C17.2, C18.2, C19.2, C20.2, C21.2, C22.2, C23.2, D1.2 (A2), J1.5, J2.2 (Ext), TJ2.1 (Pin_1_1), U1.1 (GND), U1.10 (GND), U1.12 (GND), U1.28 (GND), U2.9 (GND), U2.13 (GND), U2.15 (GND), U2.17 (GND), U2.18 (GND), U2.19 (GND), U2.24 (GND), U2.32 (GND), U2.38 (GND), U3.9 (G), U4.9 (G), X2.1 (GND), X2.3 (GND), X2.4 (GND), X2.6 (GND)
unnamed: J1.4, U2.25 (~RST)
unnamed: J2.1 (In), U1.11 (RF_IN)
unnamed: JP2.3 (B), X2.5 (OUT)
unnamed: C14.1, JP2.2 (C)
unnamed: C12.1, JP3.1 (A)
unnamed: TJ3.1 (Pin_1_1), U1.4 (1PPS), U2.21 (GNSS_PPS)
unnamed: C7.2, L2.1, R5.2, U3.1 (Vcc)
unnamed: C9.2, L4.1, R6.2, U4.1 (Vcc)

Notes on the sheet:
Bridge with 100pF 0402 Capacitor.
LNA 1
Ground Testpoint
Revision History ${PCBA_PN}-C Change jumpers to 100pF caps. REVISAR CAMINO RF

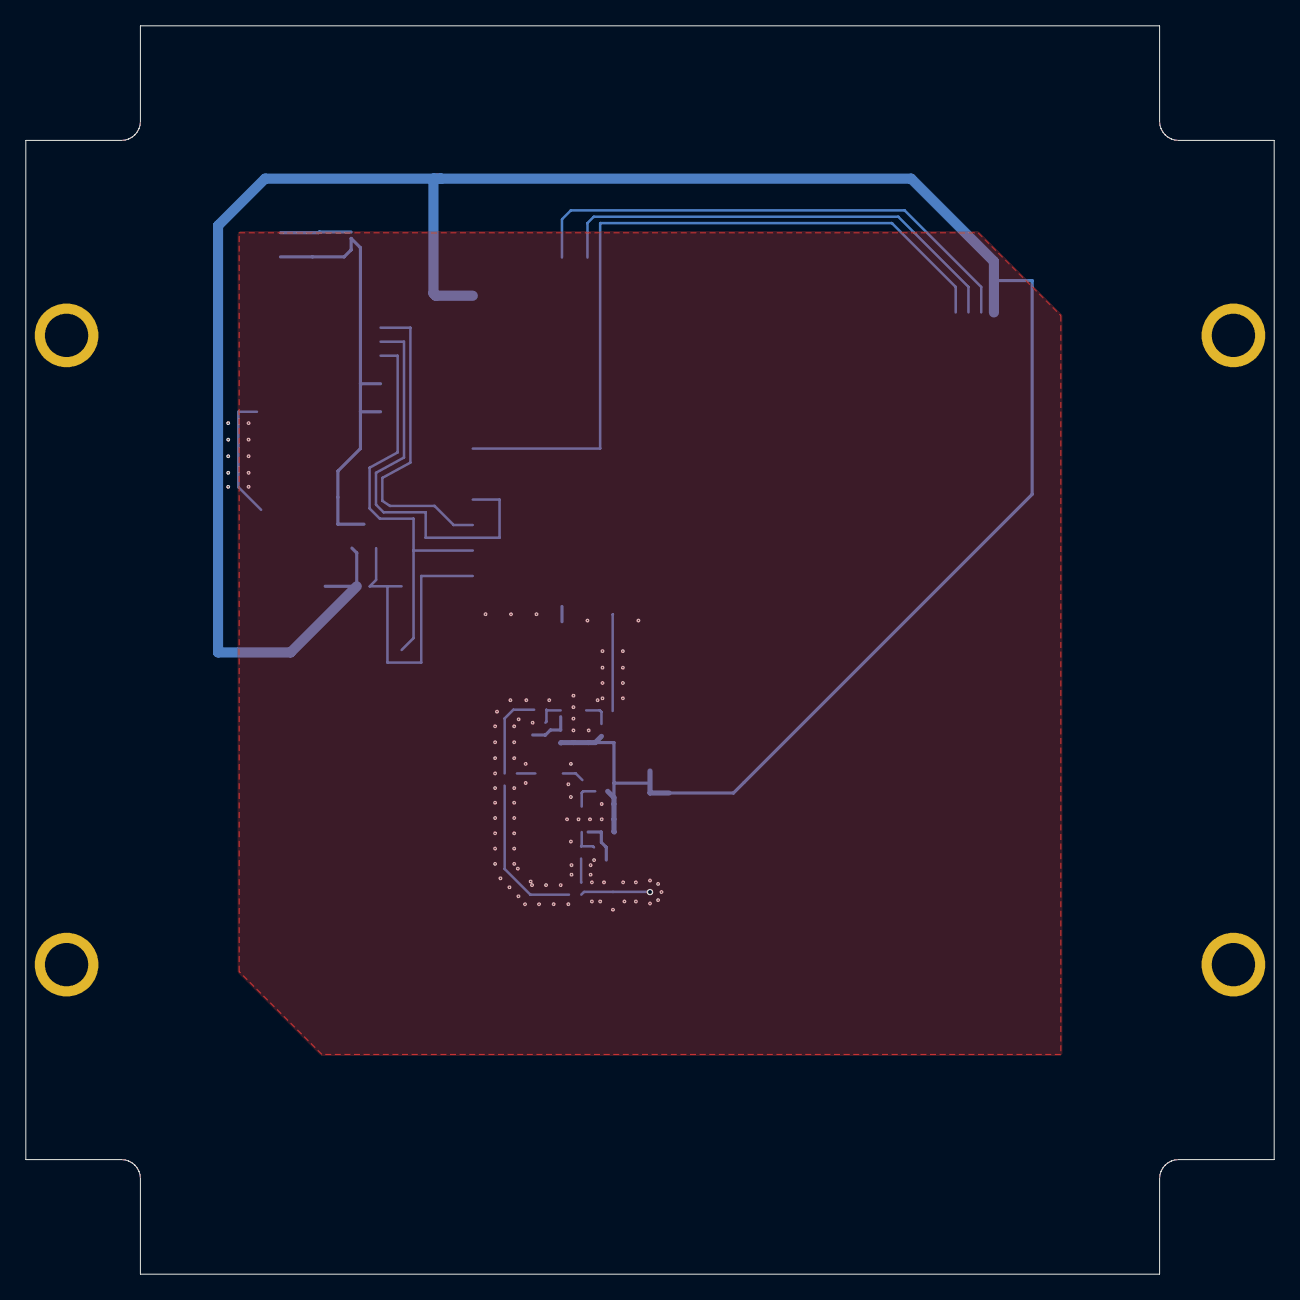
[picture p134: board ads-b.kicad_pcb from above]

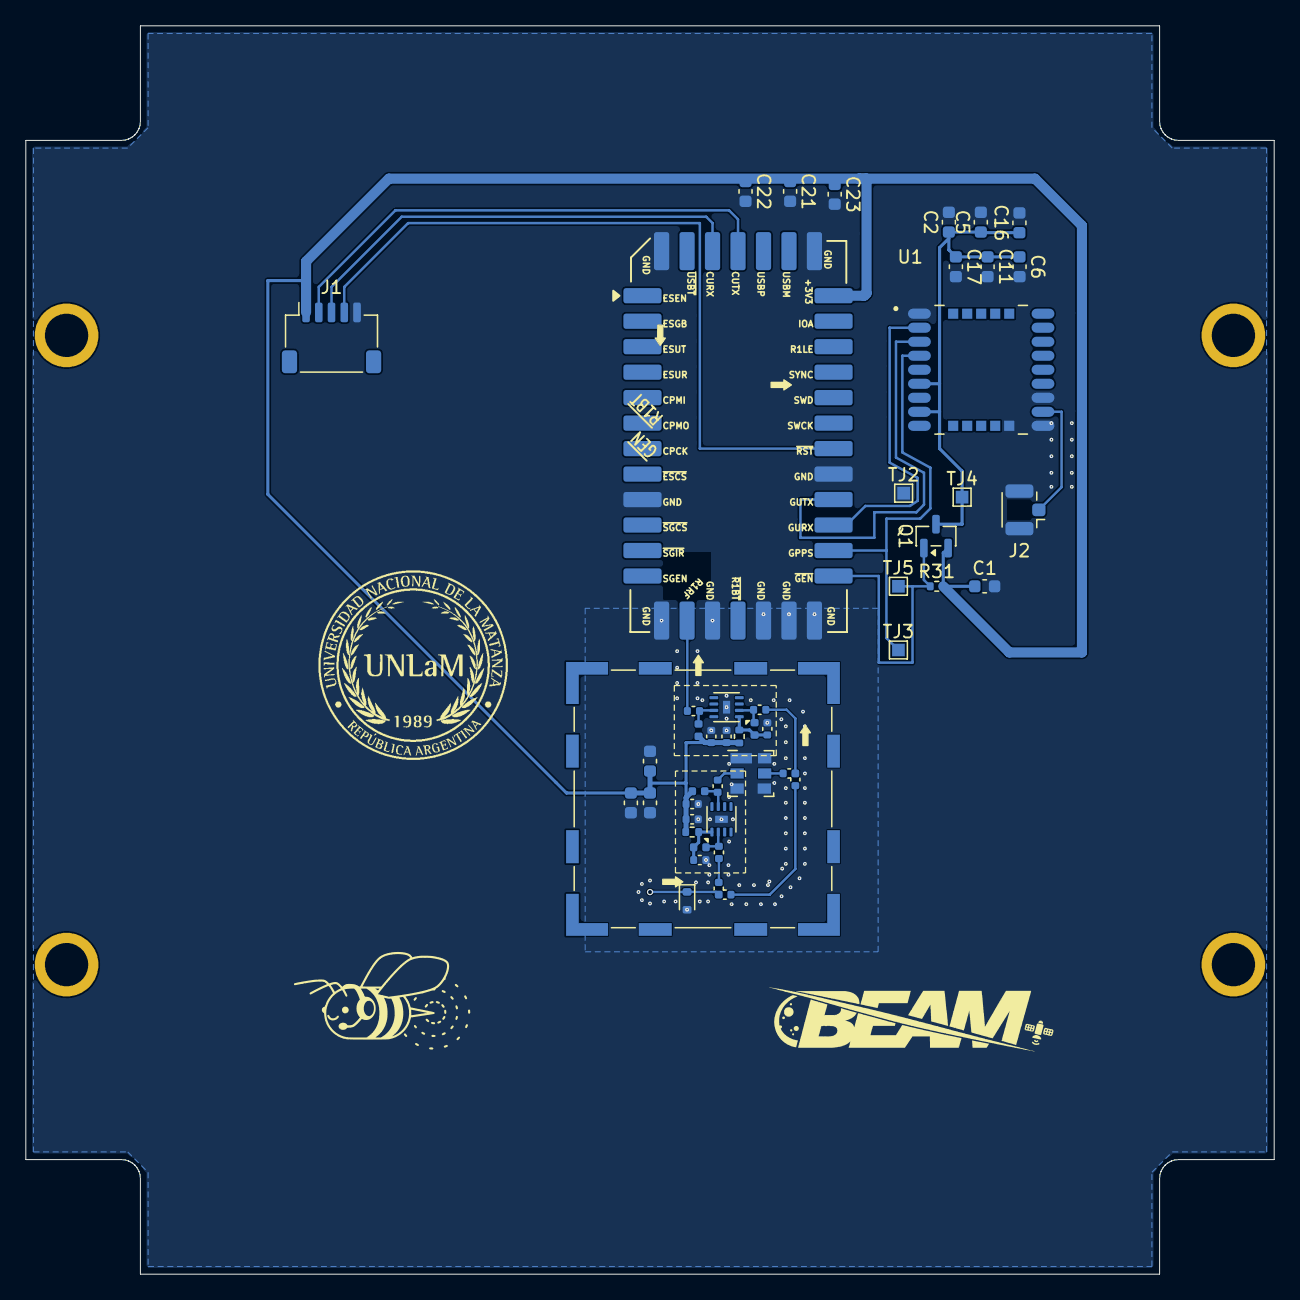
[picture p135: board ads-b.kicad_pcb from below]

Board: 4 copper layers, 98.0 x 98.0 mm, 48 parts (48 on the bottom side), 22 nets.
